TheDarkKiwi/RoboCup/robocup cad/Evil_weight.jpg

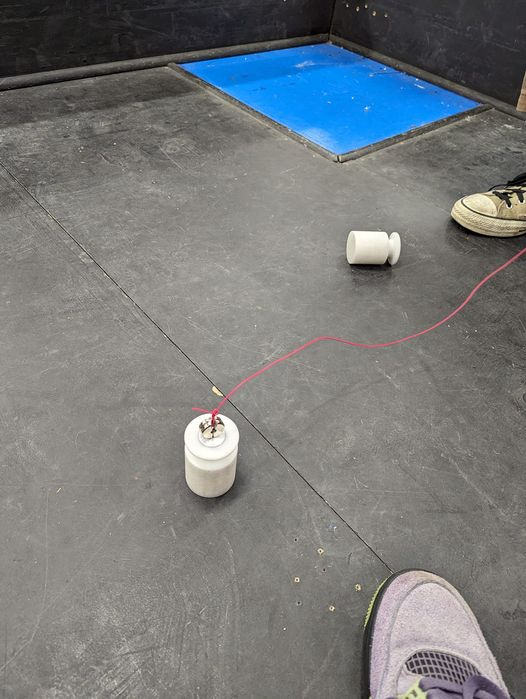
robocup cad/Evil_weight.jpg
