TheDarkKiwi/RoboCup/robocup cad/Side Cut Away.JPG

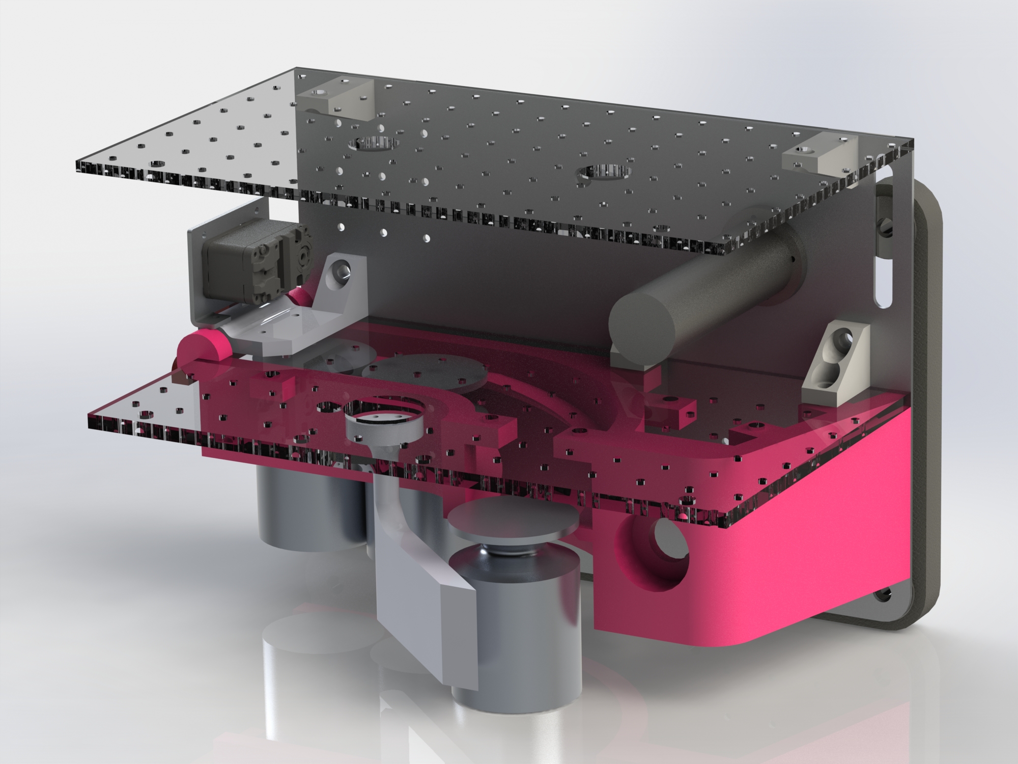
robocup cad/Side Cut Away.JPG
