TheDarkKiwi/RoboCup/robocup cad/eak38/CODE/bk_deltetemeifneeded/robocup-main/info.md

servo locations
544 = far back (push off)
1610 = flush / bypass
