TheDarkKiwi/RoboCup/robocup cad/2_half_hour render_lol.JPG

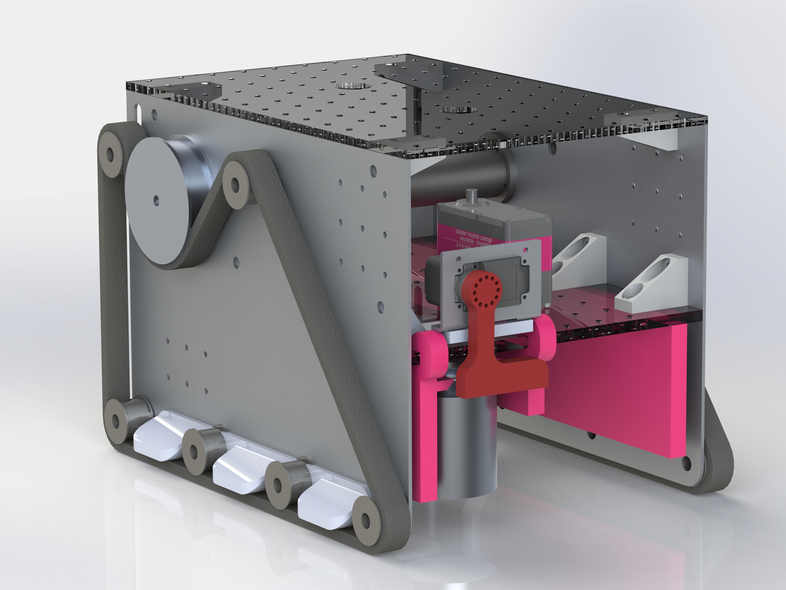
robocup cad/2_half_hour render_lol.JPG
