TheDarkKiwi/RoboCup/robocup cad/bad pic.png

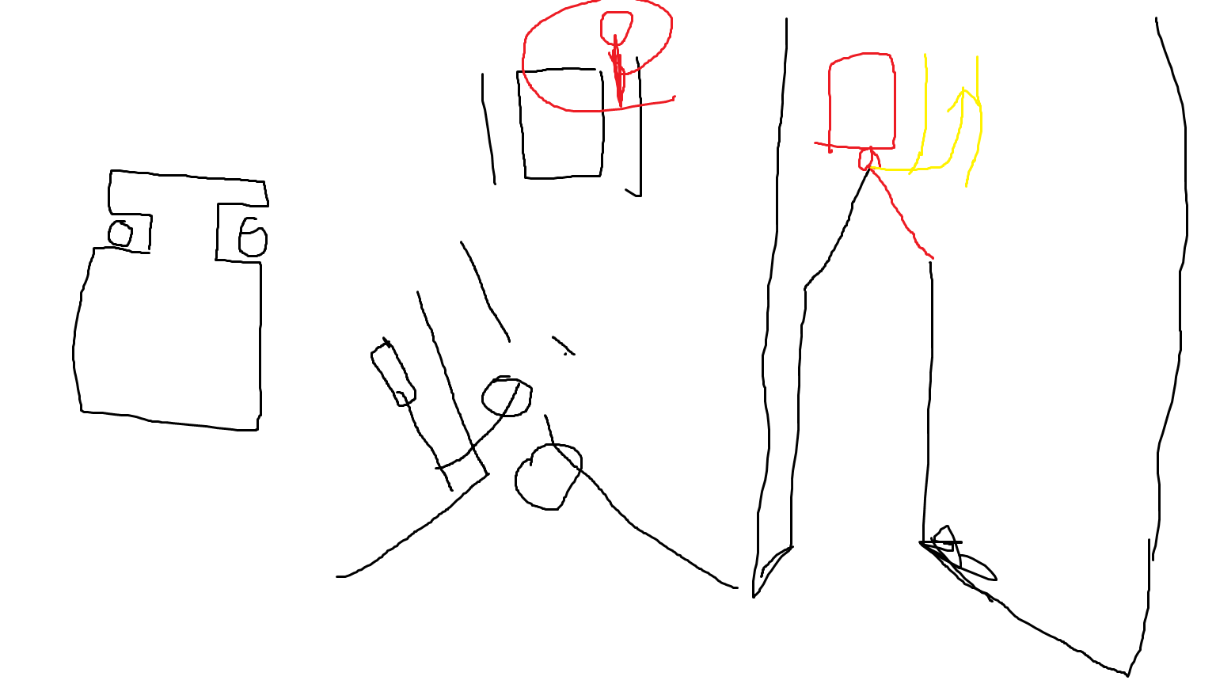
robocup cad/bad pic.png
