TheDarkKiwi/RoboCup/robocup cad/dee21/Custom Side Plate.PNG

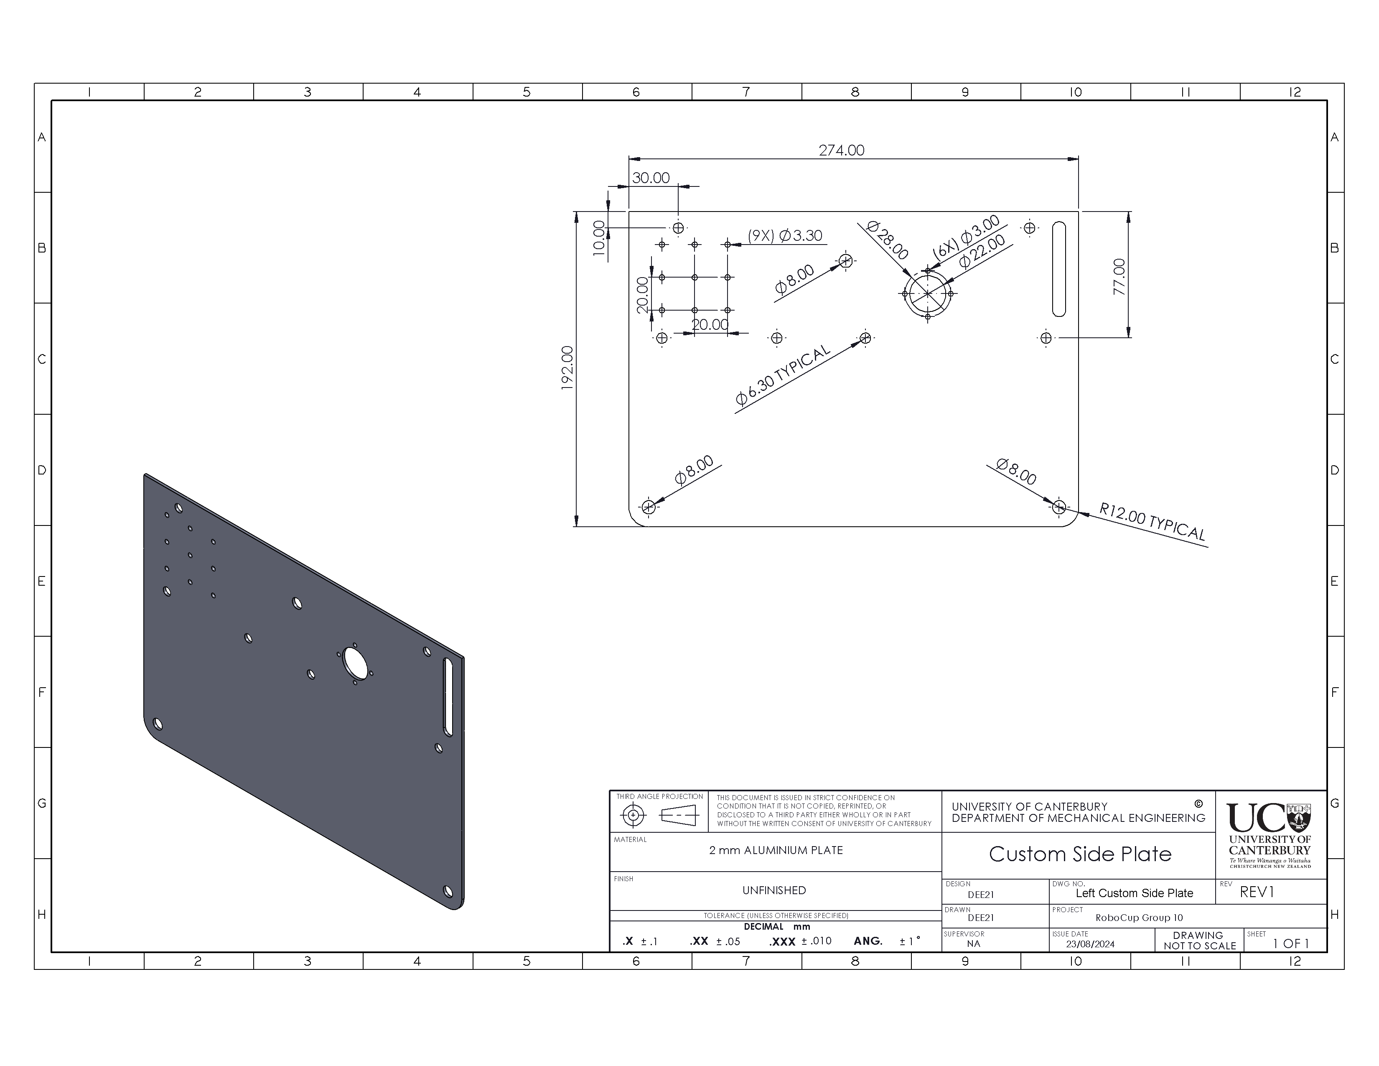
robocup cad/dee21/Custom Side Plate.PNG
