TheDarkKiwi/RoboCup/robocup cad/dee21/Internal passage way.PNG

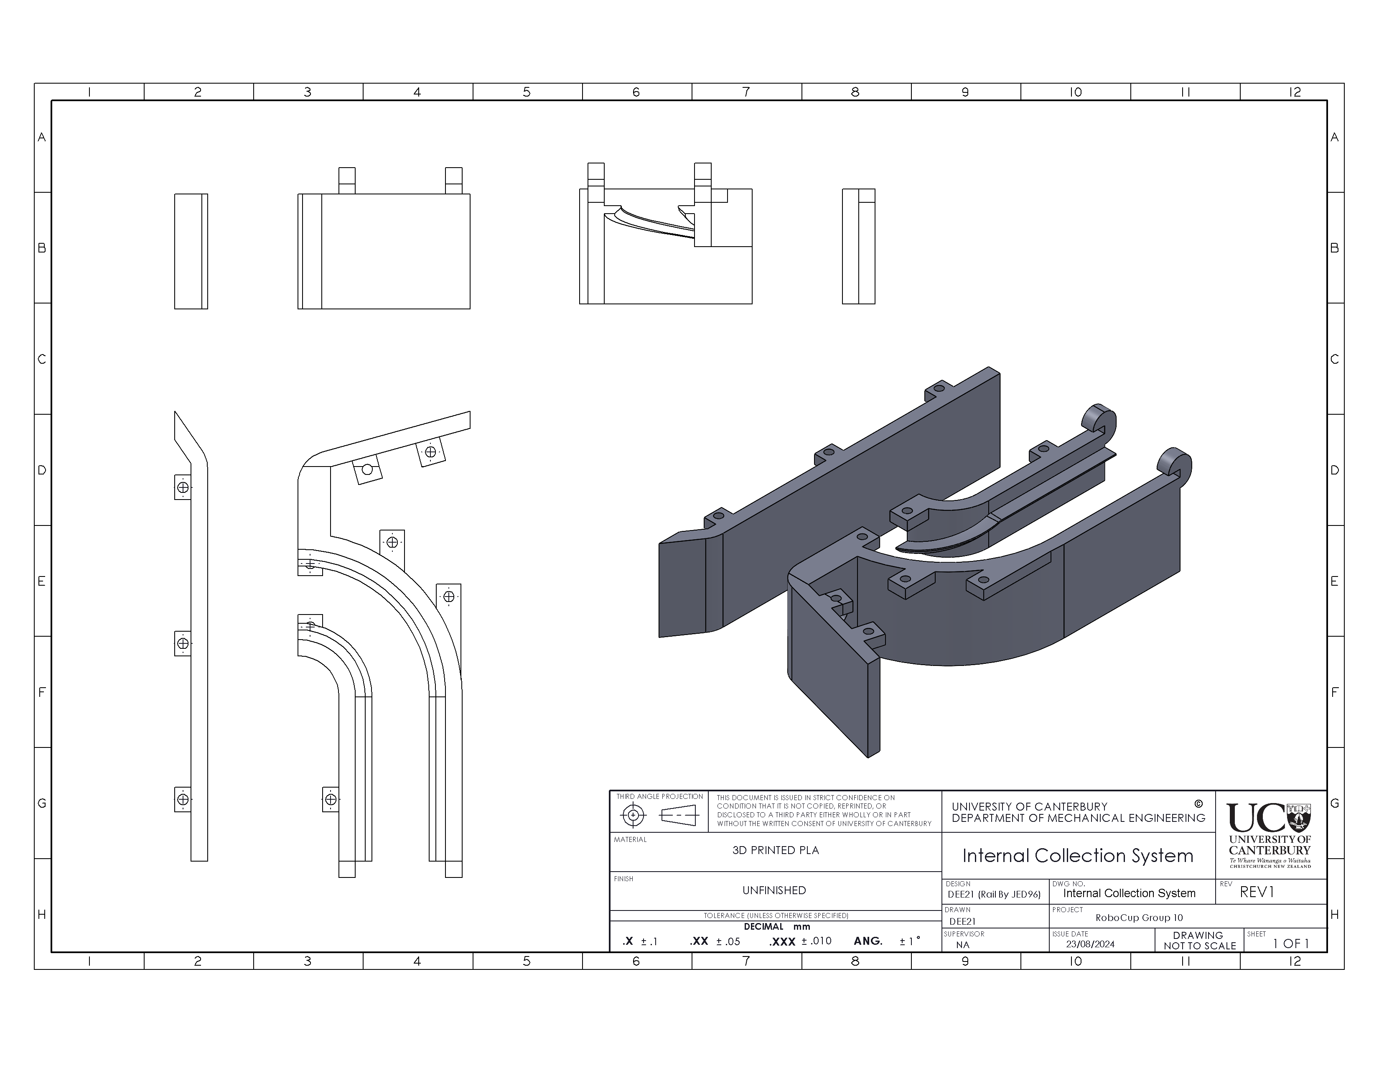
robocup cad/dee21/Internal passage way.PNG
