TheDarkKiwi/RoboCup/robocup cad/dee21/render 1.JPG

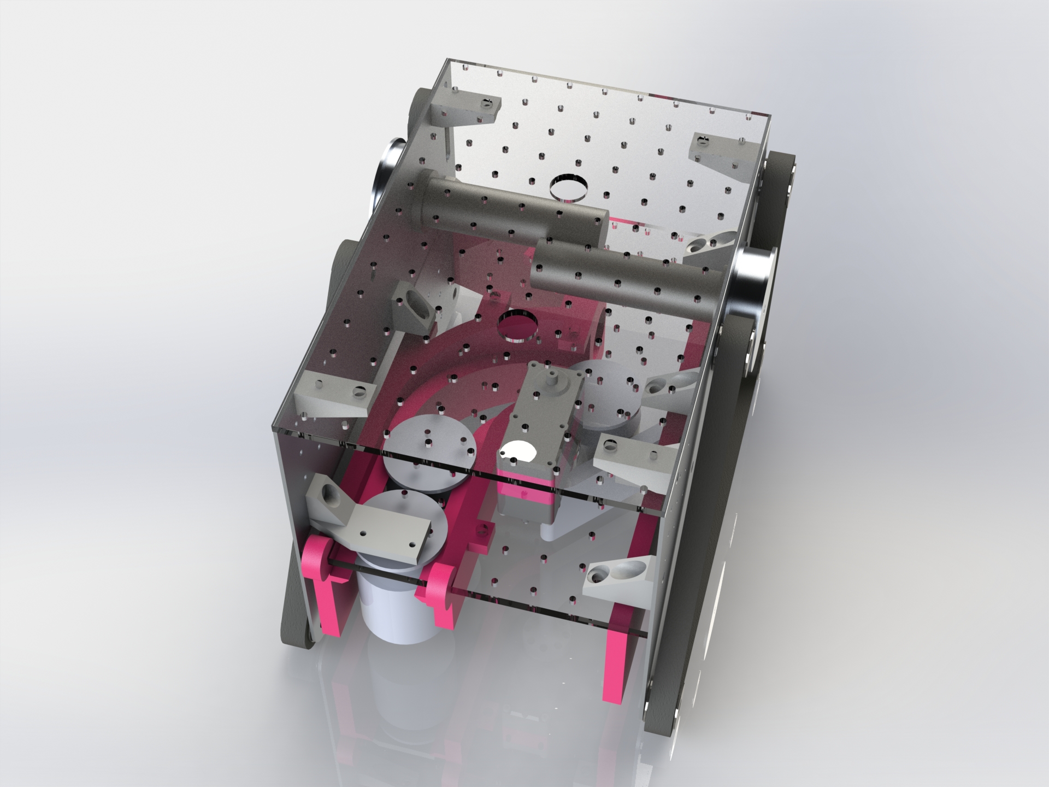
robocup cad/dee21/render 1.JPG
