TheDarkKiwi/RoboCup/robocup cad/DLparts/drs-0101-1.snapshot.2/Renderings/DRS-0101.jpg

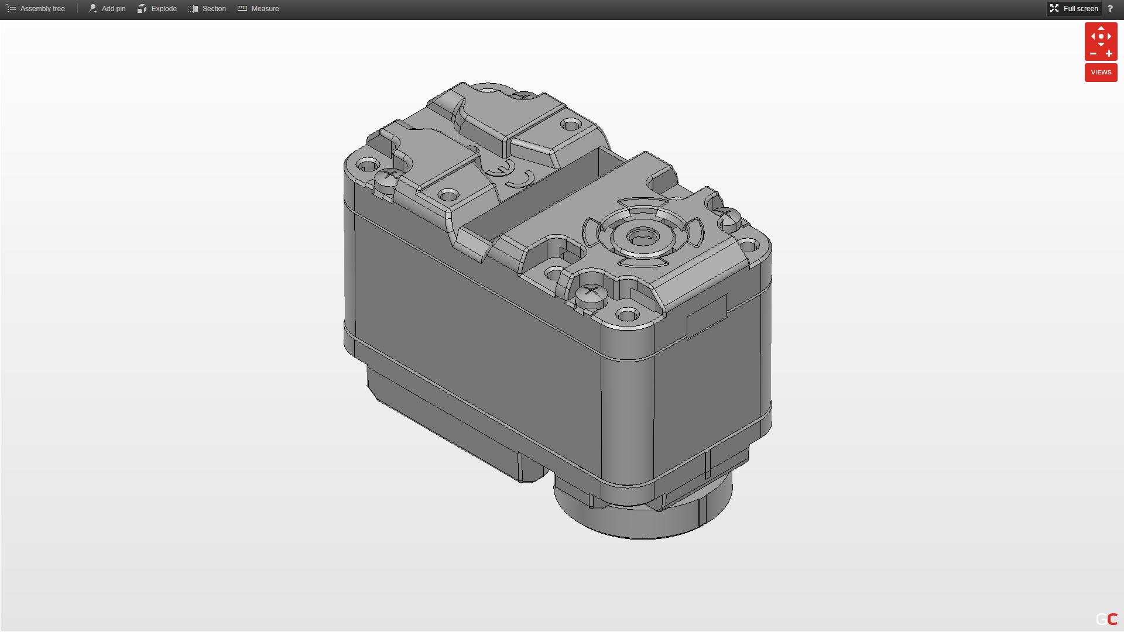
robocup cad/DLparts/drs-0101-1.snapshot.2/Renderings/DRS-0101.jpg
