TheDarkKiwi/RoboCup/robocup cad/DLparts/herculex-1.snapshot.1/Bracket.PNG

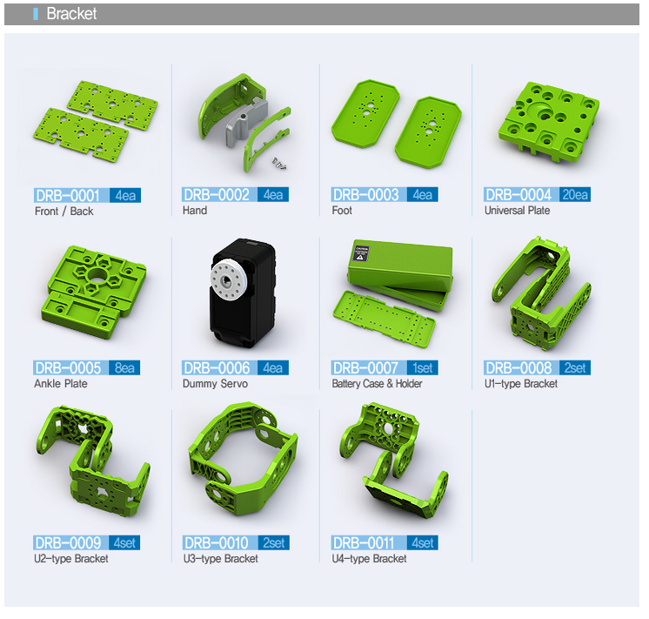
robocup cad/DLparts/herculex-1.snapshot.1/Bracket.PNG
