TheDarkKiwi/RoboCup/robocup cad/DLparts/herculex-1.snapshot.1/DRB-0001.PNG

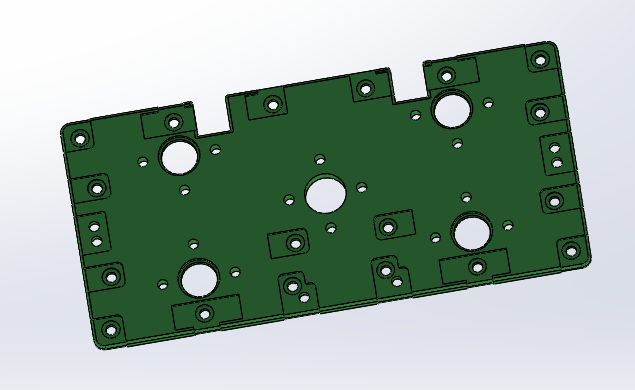
robocup cad/DLparts/herculex-1.snapshot.1/DRB-0001.PNG
