TheDarkKiwi/RoboCup/robocup cad/DLparts/herculex-1.snapshot.1/DSR-0001.JPG

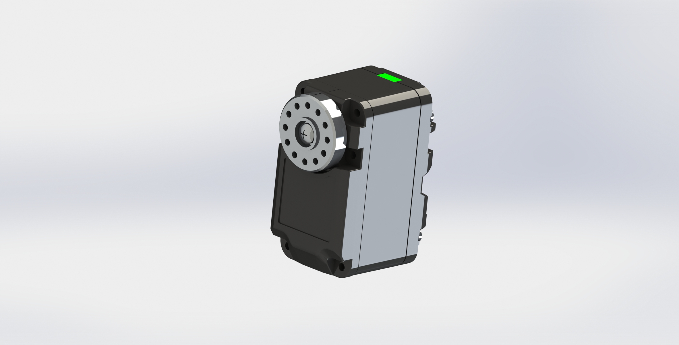
robocup cad/DLparts/herculex-1.snapshot.1/DSR-0001.JPG
