TheDarkKiwi/RoboCup/robocup cad/DLparts/herculex-1.snapshot.1/Joint.PNG

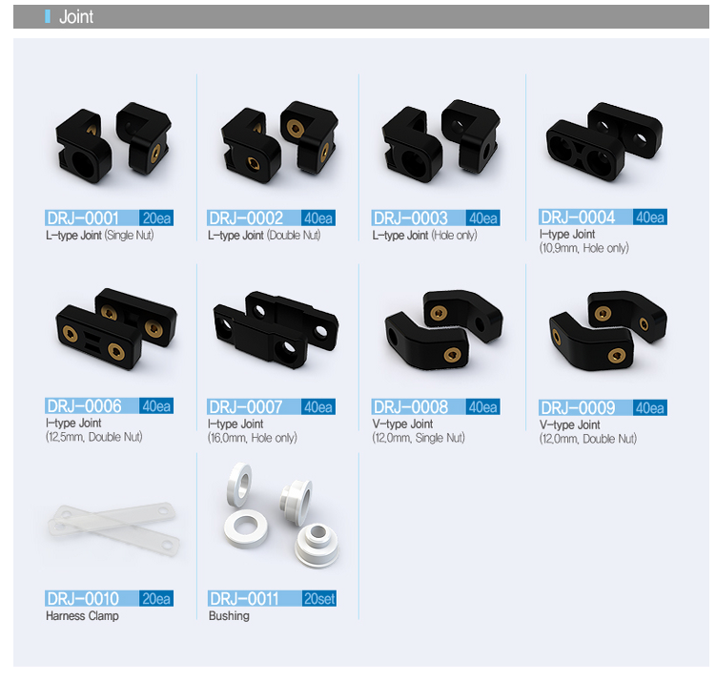
robocup cad/DLparts/herculex-1.snapshot.1/Joint.PNG
