TheDarkKiwi/RoboCup/robocup cad/Padawans_of_the_nerd_lord_accepting_their_fate.jpg

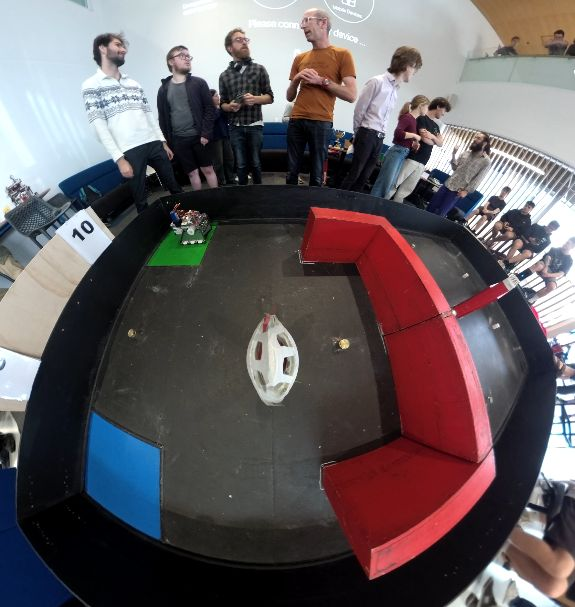
robocup cad/Padawans_of_the_nerd_lord_accepting_their_fate.jpg
