TheDarkKiwi/RoboCup/robocup cad/Screenshot 2024-08-05 134314.png

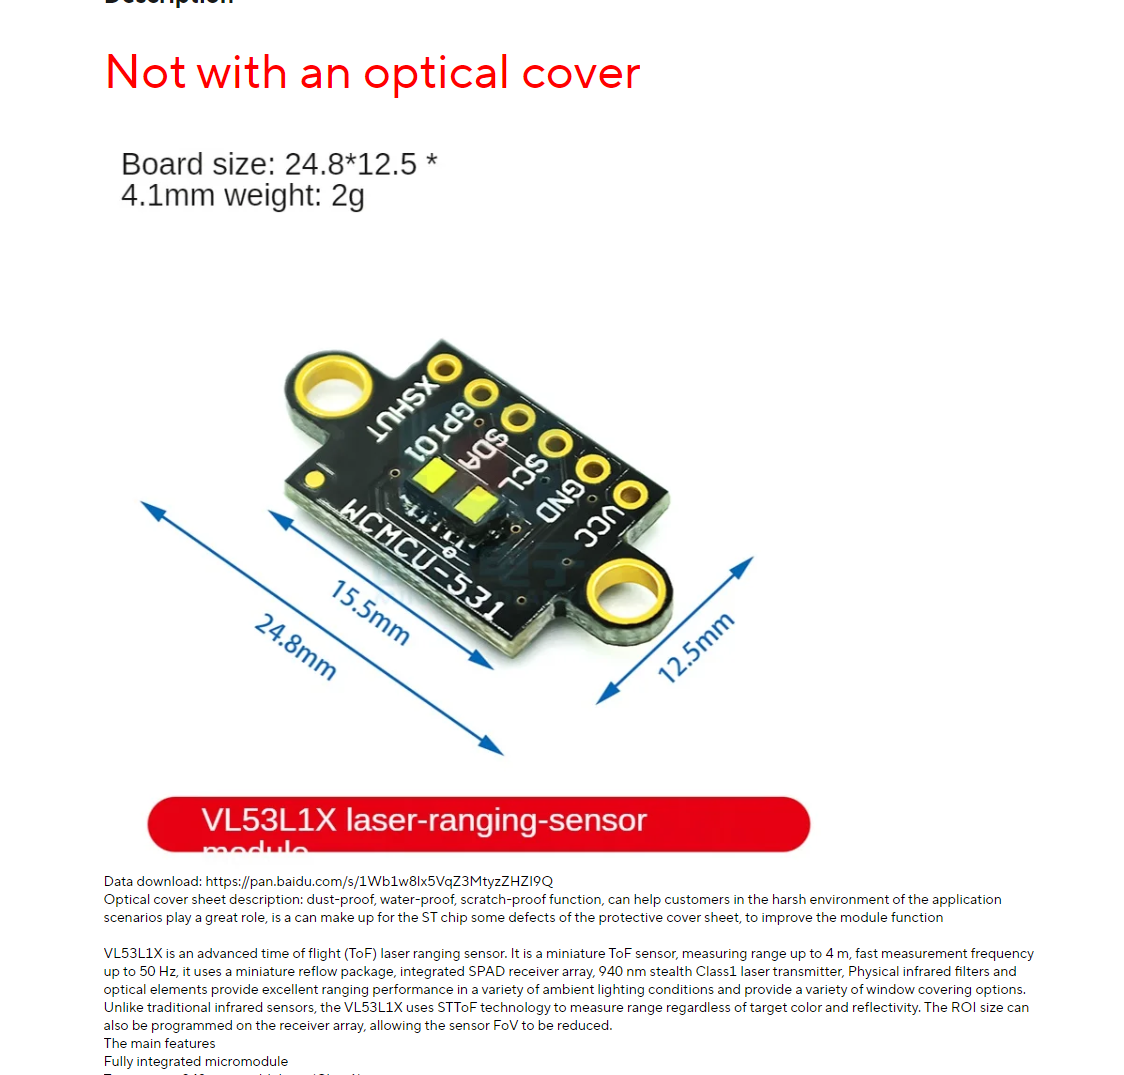
robocup cad/Screenshot 2024-08-05 134314.png
