TheDarkKiwi/RoboCup/robocup cad/DLparts/vl5310xother/Sensor assem.SLDASM

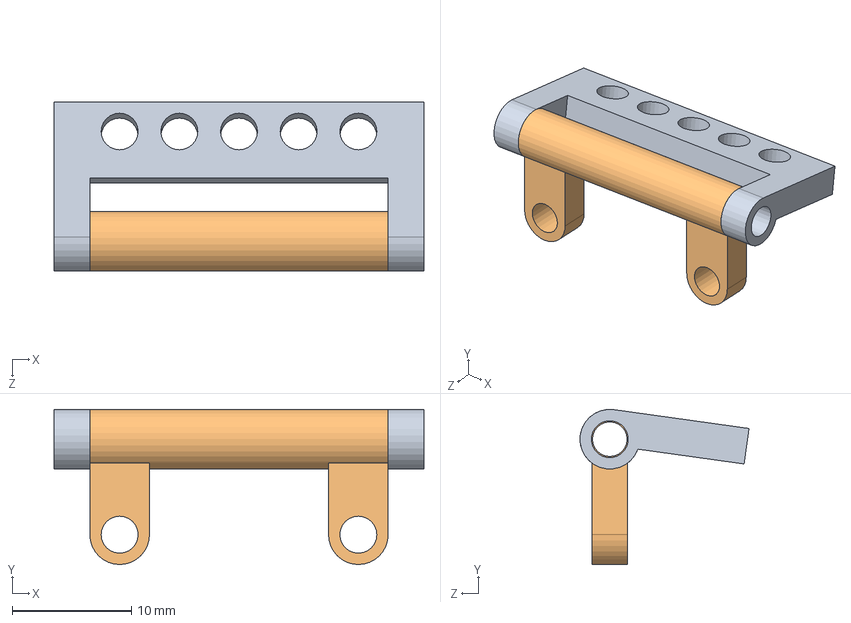
[picture p26: CAD file, 2024-12-19]
robocup cad/DLparts/vl5310xother/Sensor assem.SLDASM
31.0 x 13.0 x 14.2 mm
Sensor Mount
Sensor Mount - 2
