TheDarkKiwi/RoboCup/robocup cad/dee21/-electromagnet-customsize.SLDPRT

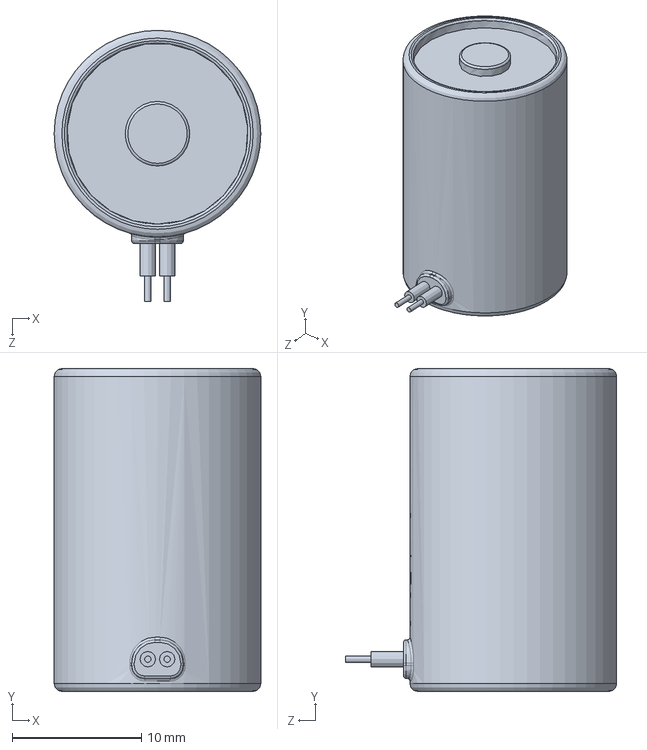
[picture p27: CAD file, 2024-12-19]
robocup cad/dee21/-electromagnet-customsize.SLDPRT
16.0 x 25.0 x 21.0 mm
