TheDarkKiwi/RoboCup/robocup cad/DLparts/drs-0101-1.snapshot.2/[HerkuleX] DRS-010X.stp

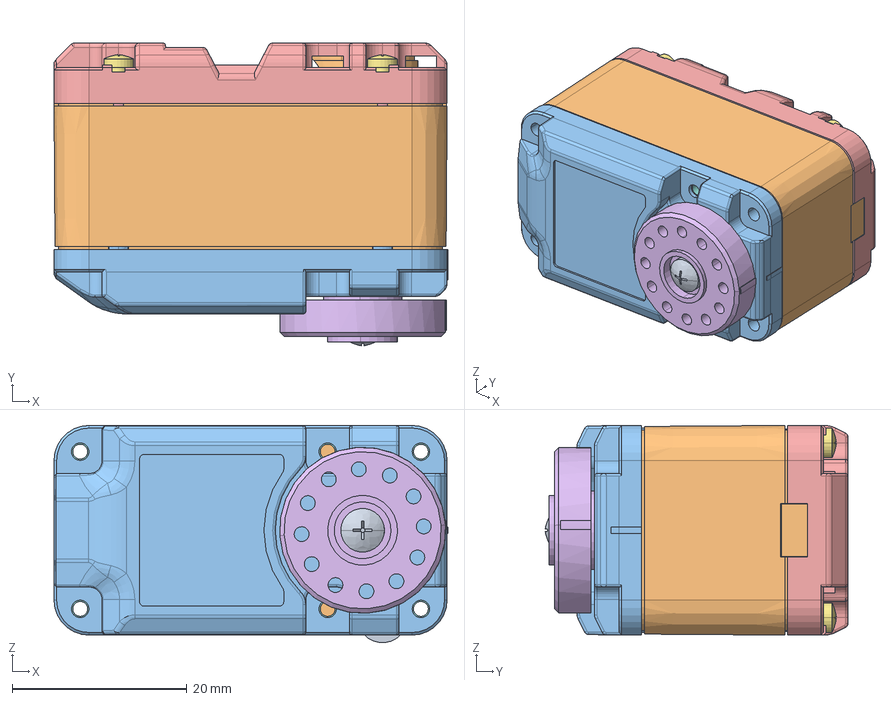
[picture p28: CAD file, 2024-12-19]
robocup cad/DLparts/drs-0101-1.snapshot.2/[HerkuleX] DRS-010X.stp
45.1 x 34.7 x 24.9 mm
CASE_228
TOP_191
MR106_9
BOTTOM_CASE_290
HORN_44
KSB1023A_T2X25NI_147 x 4
INNER_NUT_14 x 6
KSB1023A_M2_5X8Z_147
LED_LENSE_101
