TheDarkKiwi/RoboCup/robocup cad/DLparts/herculex-1.snapshot.1/bracket/DRB-0007.step

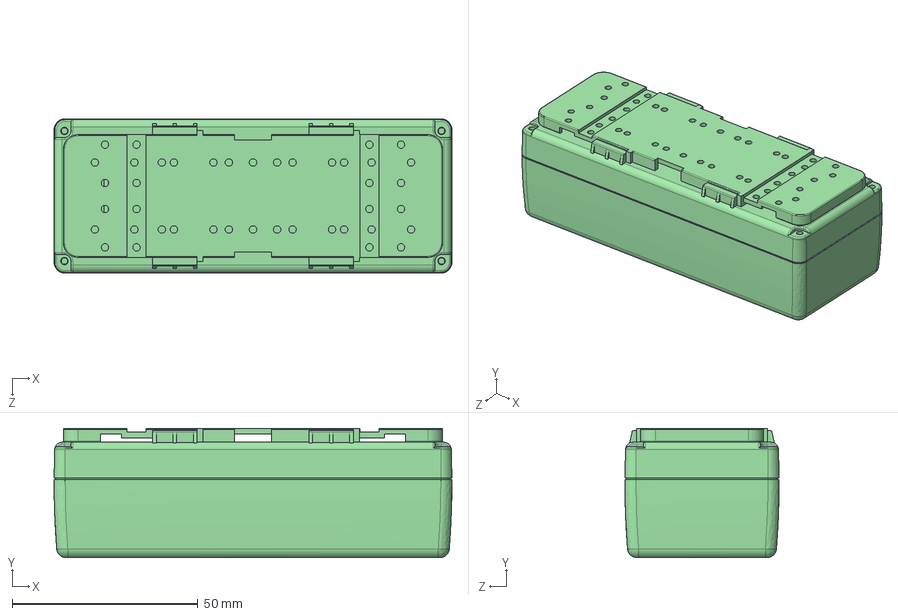
[picture p29: CAD file, 2024-12-19]
robocup cad/DLparts/herculex-1.snapshot.1/bracket/DRB-0007.step
107.0 x 34.7 x 41.5 mm
