TheDarkKiwi/RoboCup/robocup cad/DLparts/herculex-1.snapshot.1/Joint/DRJ-0006.step

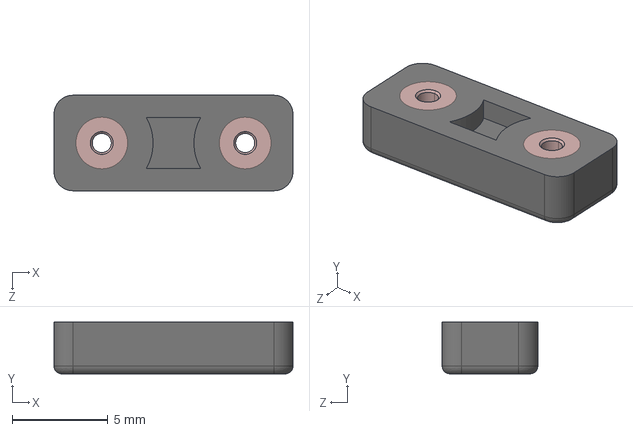
[picture p30: CAD file, 2024-12-19]
robocup cad/DLparts/herculex-1.snapshot.1/Joint/DRJ-0006.step
12.5 x 2.70 x 5.00 mm
