TheDarkKiwi/RoboCup/robocup cad/DLparts/herculex-1.snapshot.1/motor/DSR-060X.step

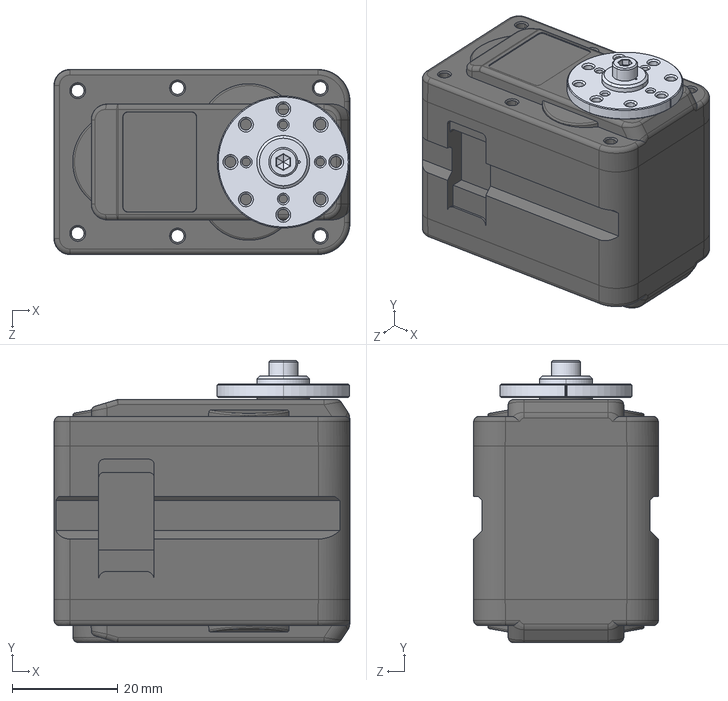
[picture p31: CAD file, 2024-12-19]
robocup cad/DLparts/herculex-1.snapshot.1/motor/DSR-060X.step
56.0 x 53.4 x 35.0 mm
