TheDarkKiwi/RoboCup/robocup cad/DLparts/vl5310xother/Sensor Mount - 2.SLDPRT

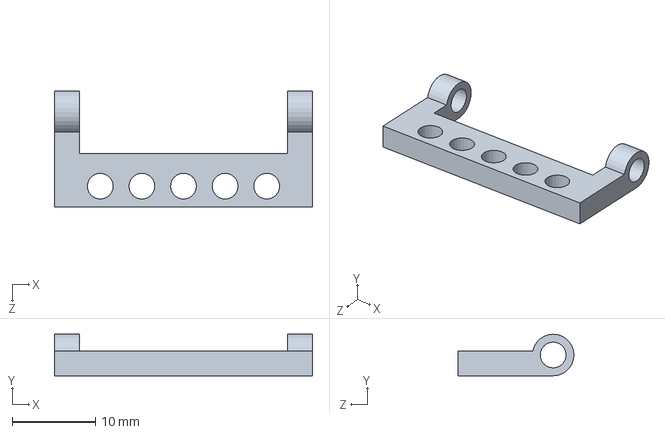
[picture p32: CAD file, 2024-12-19]
robocup cad/DLparts/vl5310xother/Sensor Mount - 2.SLDPRT
31.0 x 5.00 x 13.9 mm
