TheDarkKiwi/RoboCup/robocup cad/DLparts/vl53l0xslightlyworser/vl53l0x.STEP

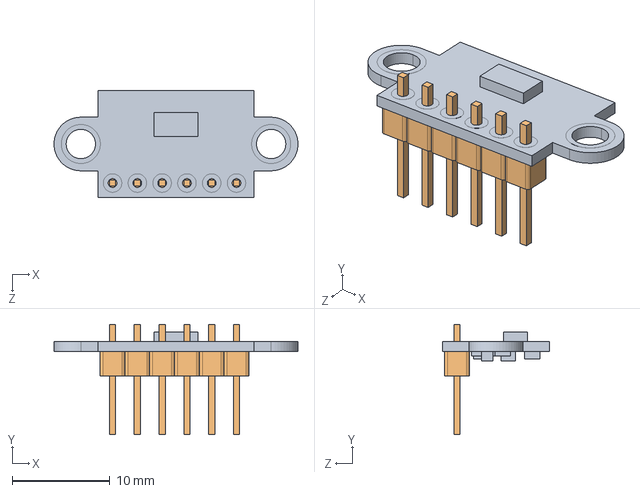
[picture p33: CAD file, 2024-12-19]
robocup cad/DLparts/vl53l0xslightlyworser/vl53l0x.STEP
25.0 x 11.3 x 11.0 mm
vl53l0x_PCB
pin_header x 6
