TheDarkKiwi/RoboCup/robocup cad/eak38/RGBsensor.SLDPRT

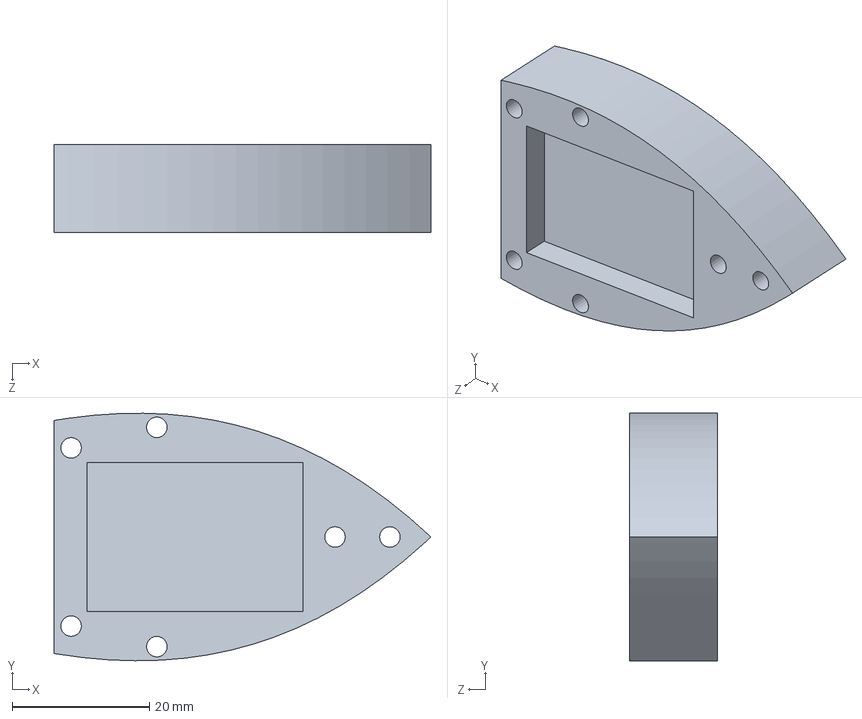
[picture p34: CAD file, 2024-12-19]
robocup cad/eak38/RGBsensor.SLDPRT
55.0 x 36.1 x 12.9 mm
