TheDarkKiwi/RoboCup/robocup cad/jed96/Battery holder.SLDPRT

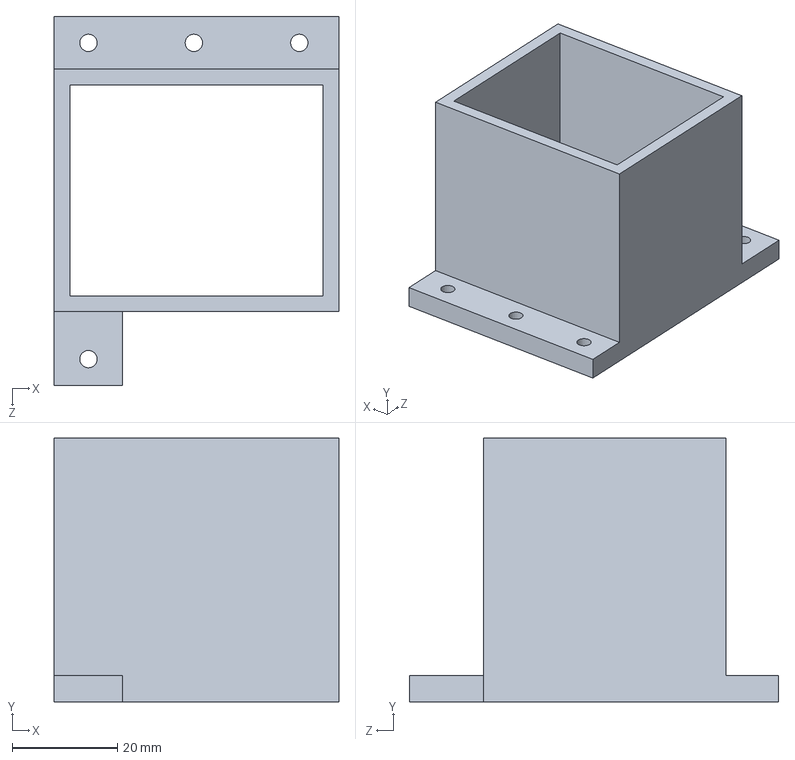
[picture p35: CAD file, 2024-12-19]
robocup cad/jed96/Battery holder.SLDPRT
54.0 x 50.0 x 70.0 mm
