TheDarkKiwi/RoboCup/robocup cad/joint/servo mag arm 2.SLDPRT

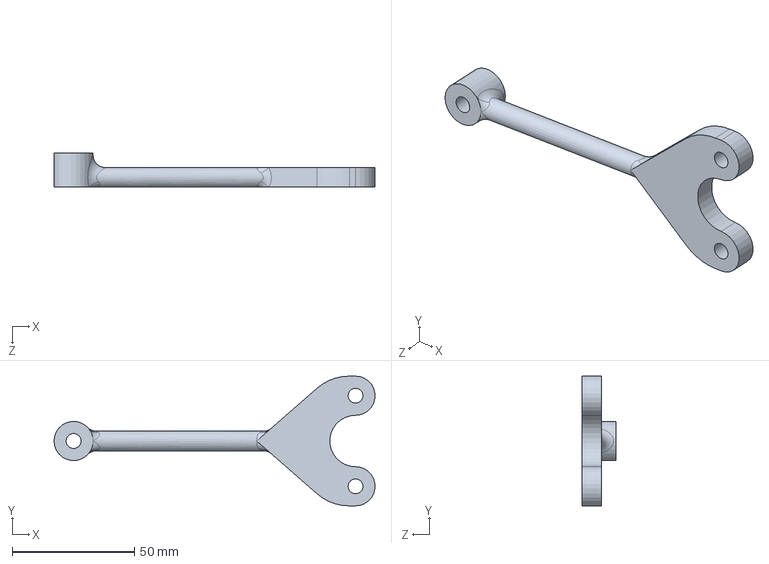
[picture p36: CAD file, 2024-12-19]
robocup cad/joint/servo mag arm 2.SLDPRT
131.1 x 53.0 x 14.0 mm
