TheDarkKiwi/RoboCup/robocup cad/WheelSliderEDIT.SLDPRT

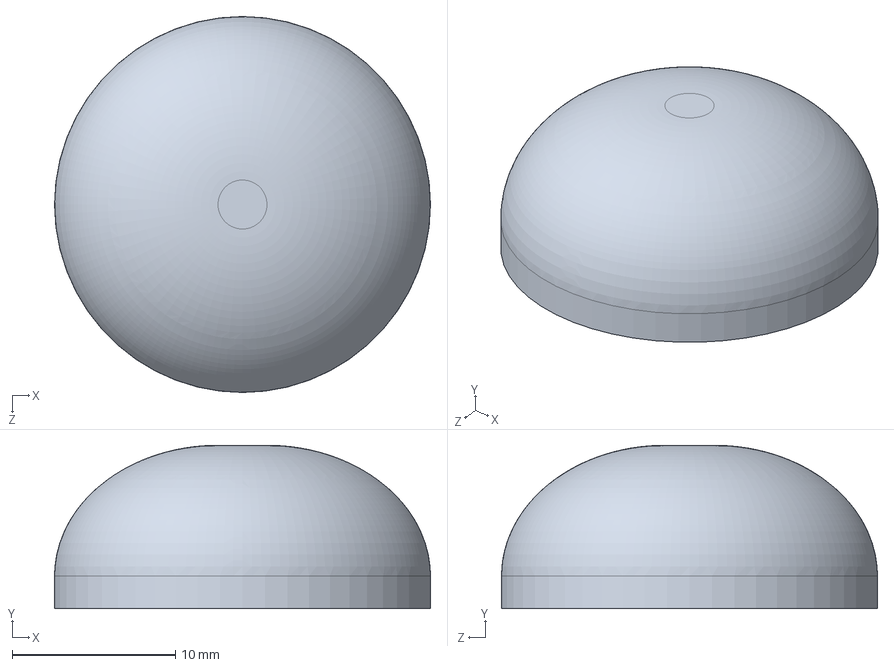
[picture p37: CAD file, 2024-12-19]
robocup cad/WheelSliderEDIT.SLDPRT
23.0 x 10.0 x 23.0 mm
