TheDarkKiwi/RoboCup/robocup cad/bearing sliders.STL

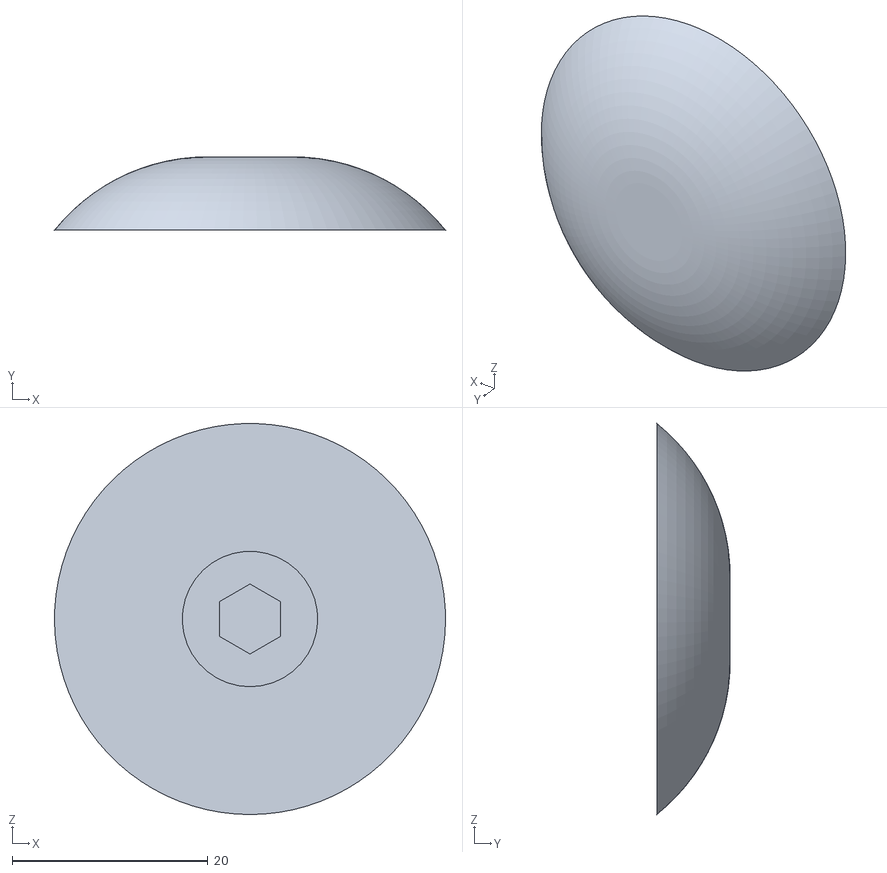
[picture p38: CAD file, 2024-12-19]
robocup cad/bearing sliders.STL
40.0 x 7.50 x 40.0
