TheDarkKiwi/RoboCup/robocup cad/dee21/side2collection3.SLDPRT

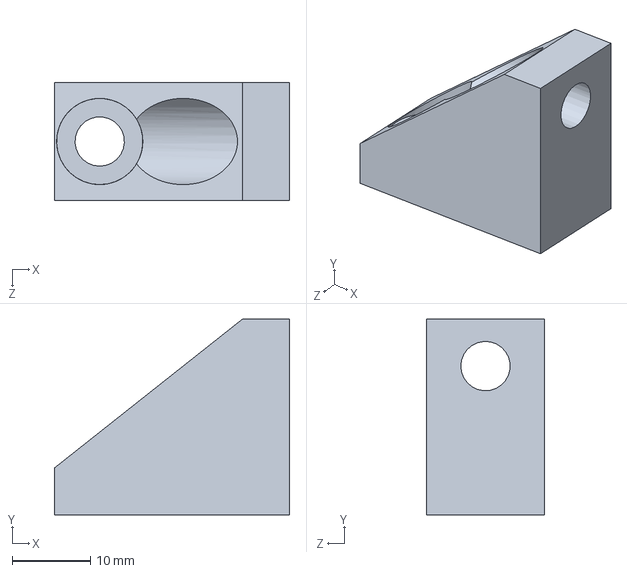
[picture p39: CAD file, 2024-12-19]
robocup cad/dee21/side2collection3.SLDPRT
30.0 x 25.0 x 15.0 mm
