TheDarkKiwi/RoboCup/robocup cad/DLparts/herculex-1.snapshot.1/bracket/DRB-0008.SLDPRT

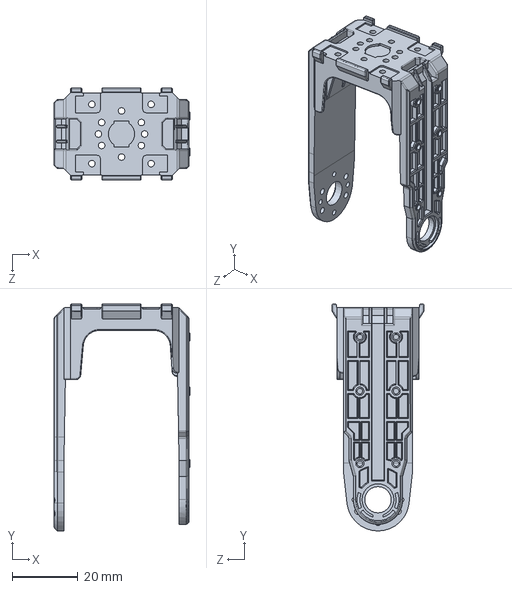
[picture p40: CAD file, 2024-12-19]
robocup cad/DLparts/herculex-1.snapshot.1/bracket/DRB-0008.SLDPRT
41.3 x 69.0 x 28.0 mm
