TheDarkKiwi/RoboCup/robocup cad/DLparts/herculex-1.snapshot.1/Joint/DRJ-0003.step

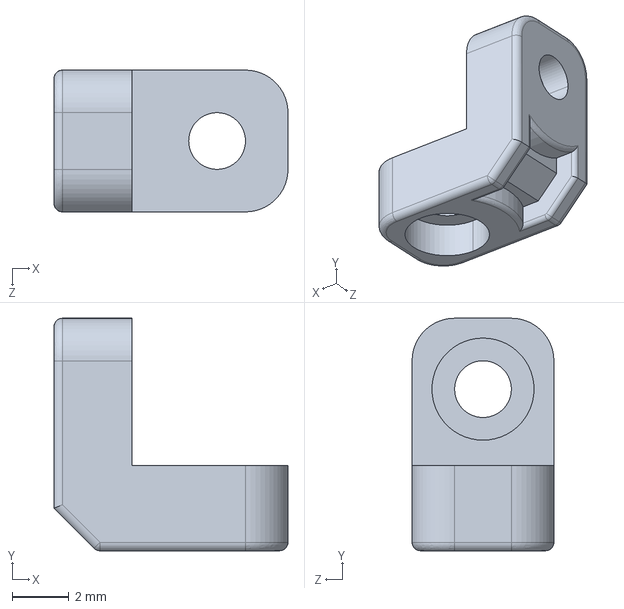
[picture p41: CAD file, 2024-12-19]
robocup cad/DLparts/herculex-1.snapshot.1/Joint/DRJ-0003.step
8.25 x 8.20 x 5.00 mm
