TheDarkKiwi/RoboCup/robocup cad/DLparts/herculex-1.snapshot.1/motor/DSR-040X.step

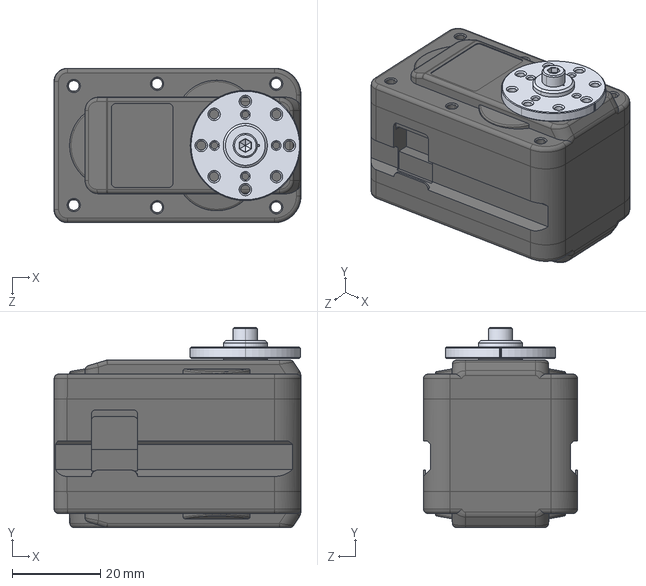
[picture p42: CAD file, 2024-12-19]
robocup cad/DLparts/herculex-1.snapshot.1/motor/DSR-040X.step
56.0 x 45.4 x 35.0 mm
