TheDarkKiwi/RoboCup/robocup cad/DLparts/vl5310xother/Sensor Mount.SLDPRT

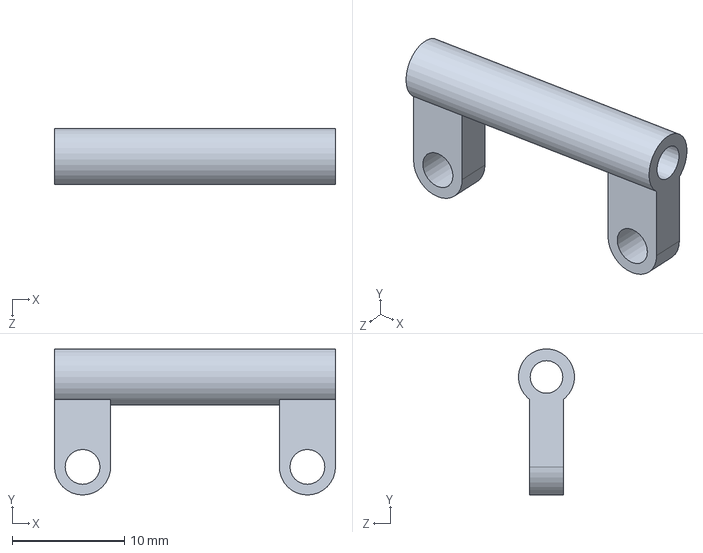
[picture p43: CAD file, 2024-12-19]
robocup cad/DLparts/vl5310xother/Sensor Mount.SLDPRT
25.0 x 13.0 x 5.00 mm
