TheDarkKiwi/RoboCup/robocup cad/DLparts/vl53l0xslightlyworser/vl53l0x no headers.STEP

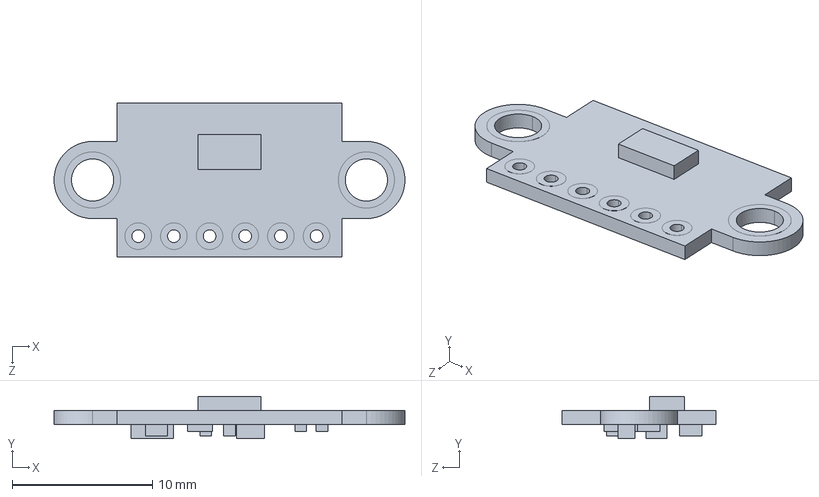
[picture p44: CAD file, 2024-12-19]
robocup cad/DLparts/vl53l0xslightlyworser/vl53l0x no headers.STEP
25.0 x 3.00 x 11.0 mm
