TheDarkKiwi/RoboCup/robocup cad/eak38/Door3.SLDPRT

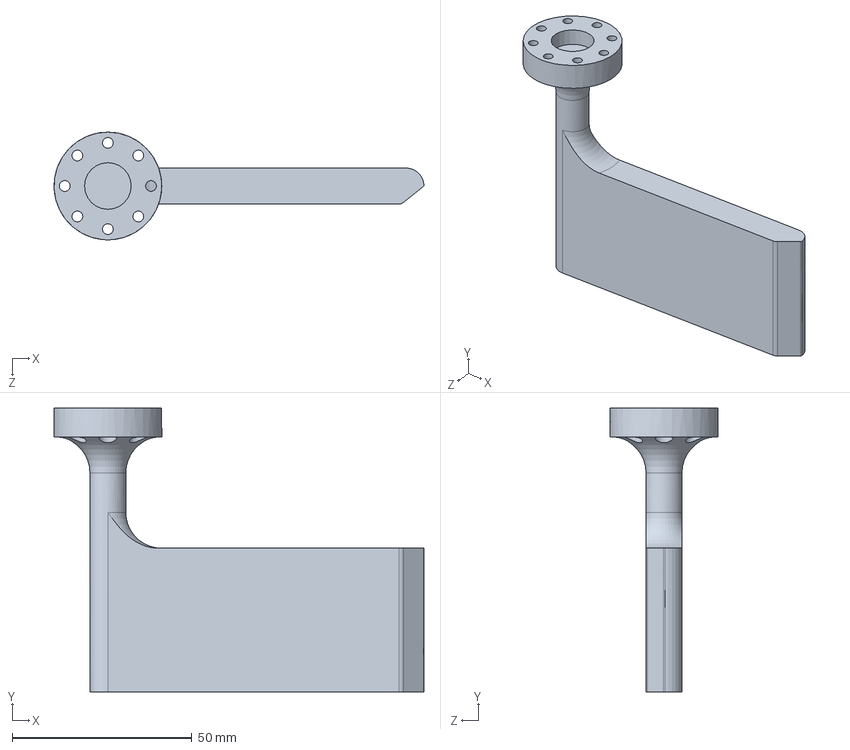
[picture p45: CAD file, 2024-12-19]
robocup cad/eak38/Door3.SLDPRT
103.0 x 79.0 x 30.0 mm
