TheDarkKiwi/RoboCup/robocup cad/jed96/entry.SLDPRT

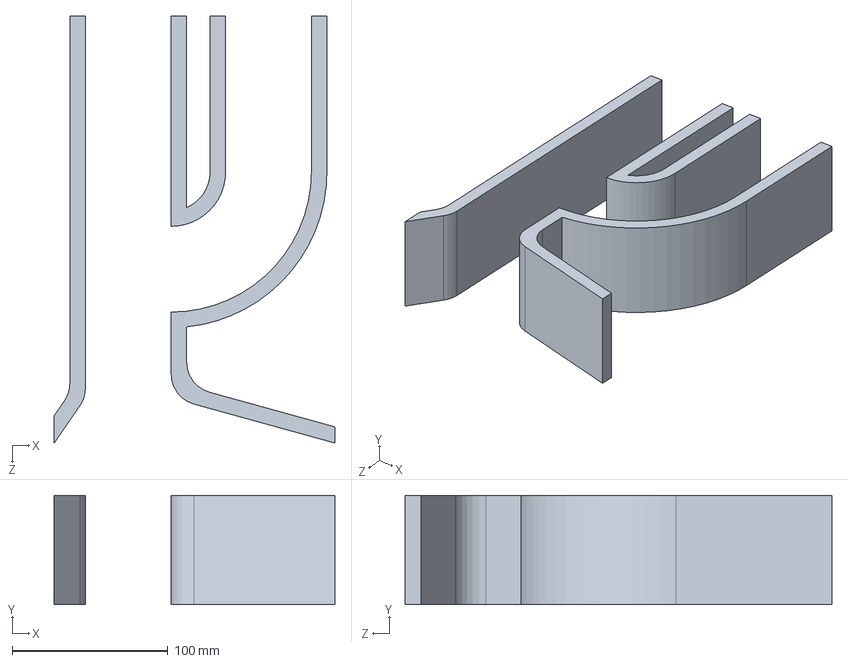
[picture p46: CAD file, 2024-12-19]
robocup cad/jed96/entry.SLDPRT
180.0 x 70.0 x 274.0 mm
