TheDarkKiwi/RoboCup/robocup cad/joint/electromagnet.SLDPRT

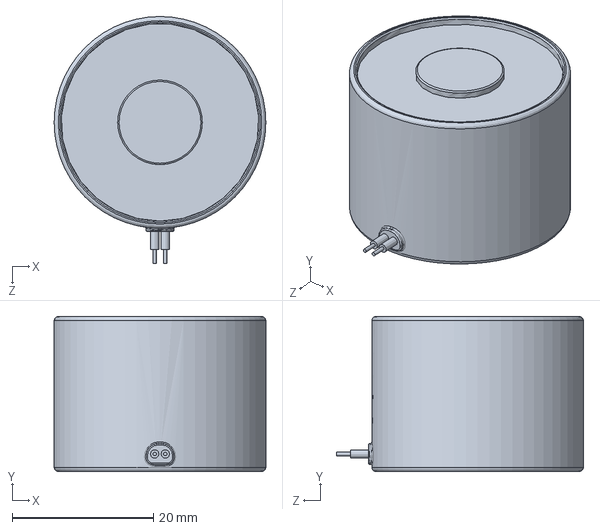
[picture p47: CAD file, 2024-12-19]
robocup cad/joint/electromagnet.SLDPRT
30.0 x 22.0 x 35.0 mm
