TheDarkKiwi/RoboCup/robocup cad/DLparts/herculex-1.snapshot.1/bracket/DRB-0005.step

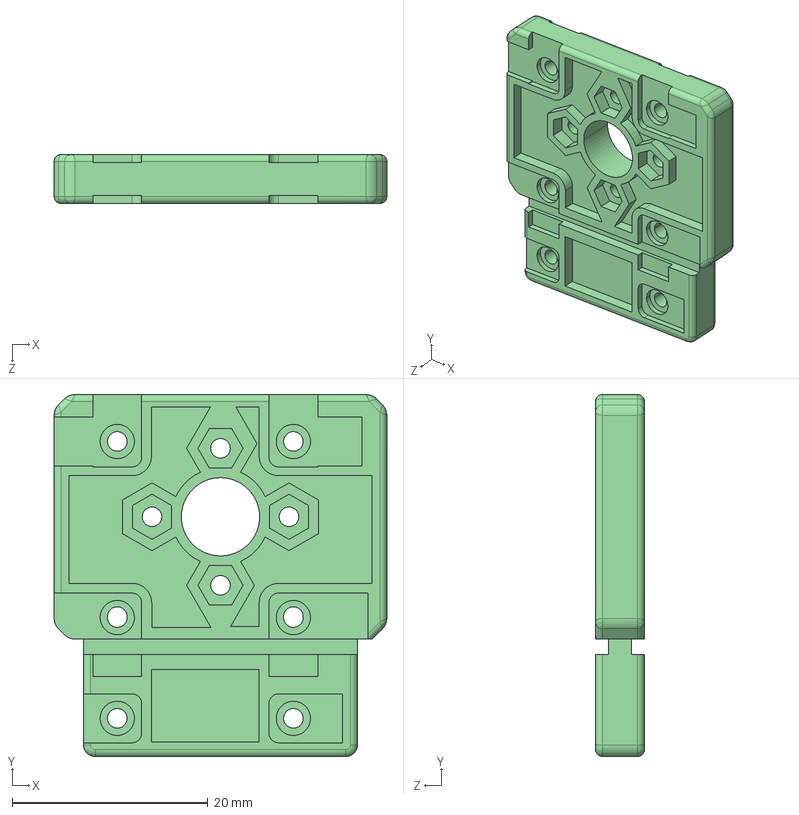
[picture p48: CAD file, 2024-12-19]
robocup cad/DLparts/herculex-1.snapshot.1/bracket/DRB-0005.step
34.0 x 37.0 x 5.00 mm
