TheDarkKiwi/RoboCup/robocup cad/DLparts/herculex-1.snapshot.1/Joint/DRJ-0004.step

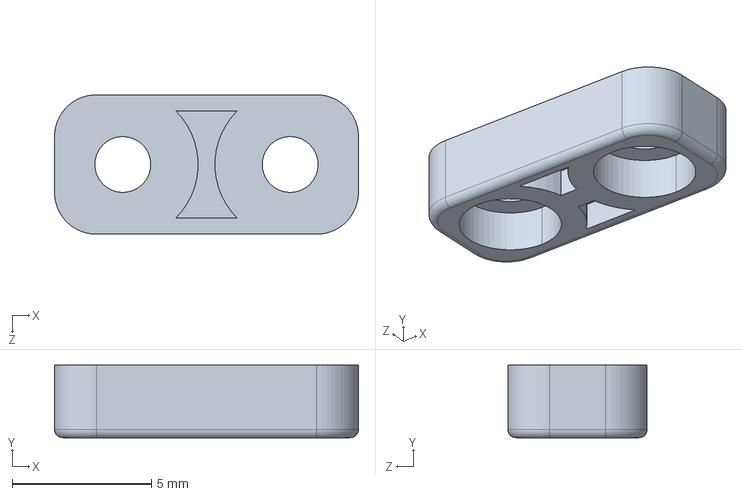
[picture p49: CAD file, 2024-12-19]
robocup cad/DLparts/herculex-1.snapshot.1/Joint/DRJ-0004.step
10.9 x 2.60 x 5.00 mm
