TheDarkKiwi/RoboCup/robocup cad/DLparts/herculex-1.snapshot.1/motor/DSR-0101.SLDPRT

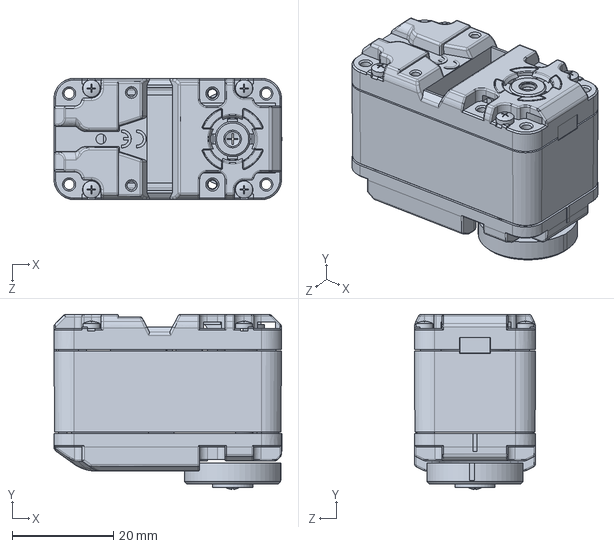
[picture p50: CAD file, 2024-12-19]
robocup cad/DLparts/herculex-1.snapshot.1/motor/DSR-0101.SLDPRT
45.1 x 34.7 x 24.0 mm
