TheDarkKiwi/RoboCup/robocup cad/eak38/smartservobracket-MECH2305.SLDPRT

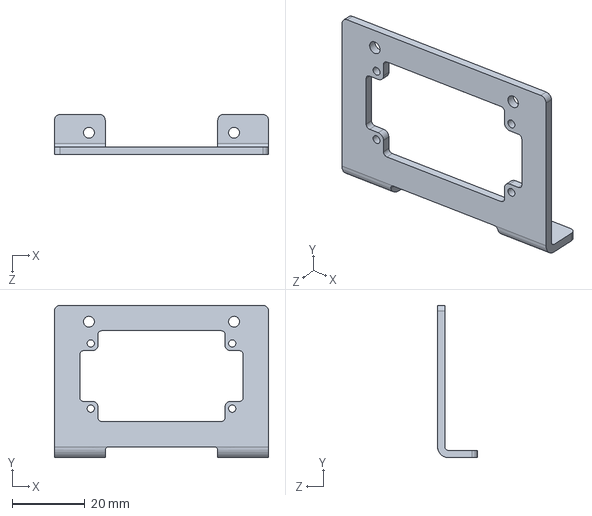
[picture p51: CAD file, 2024-12-19]
robocup cad/eak38/smartservobracket-MECH2305.SLDPRT
59.0 x 42.0 x 11.0 mm
