TheDarkKiwi/RoboCup/robocup cad/jed96/herkulex_motor.SLDPRT

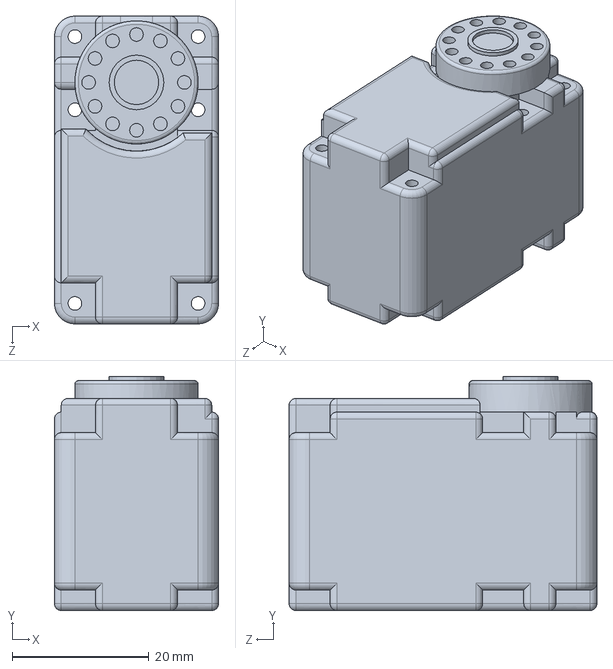
[picture p52: CAD file, 2024-12-19]
robocup cad/jed96/herkulex_motor.SLDPRT
24.0 x 34.2 x 45.0 mm
