TheDarkKiwi/RoboCup/robocup cad/joint/60kg servo mount.SLDPRT

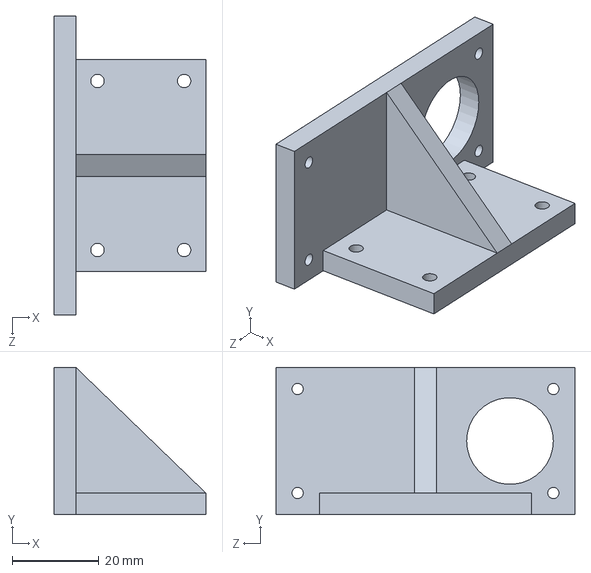
[picture p53: CAD file, 2024-12-19]
robocup cad/joint/60kg servo mount.SLDPRT
35.0 x 34.0 x 69.0 mm
