TheDarkKiwi/RoboCup/robocup cad/Skids.SLDPRT

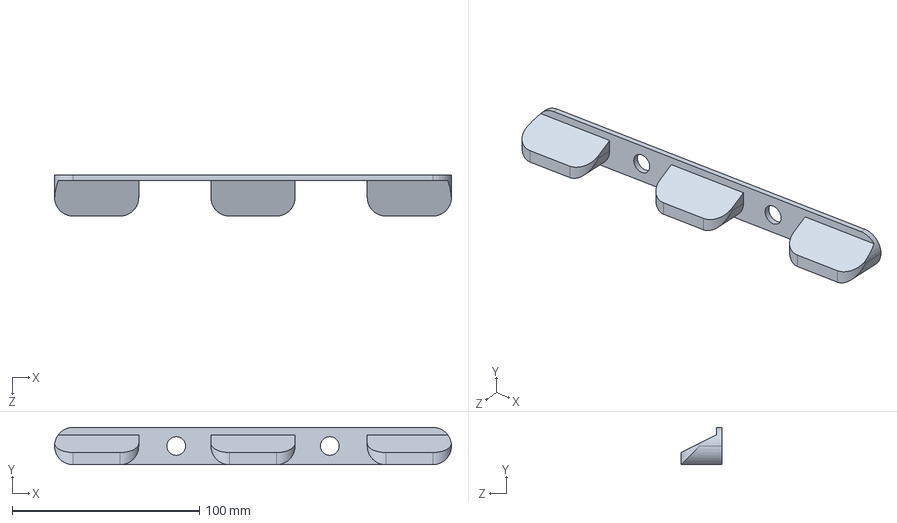
[picture p54: CAD file, 2024-12-19]
robocup cad/Skids.SLDPRT
212.0 x 20.0 x 22.0 mm
