TheDarkKiwi/RoboCup/robocup cad/dee21/Internal passage way 3.STL

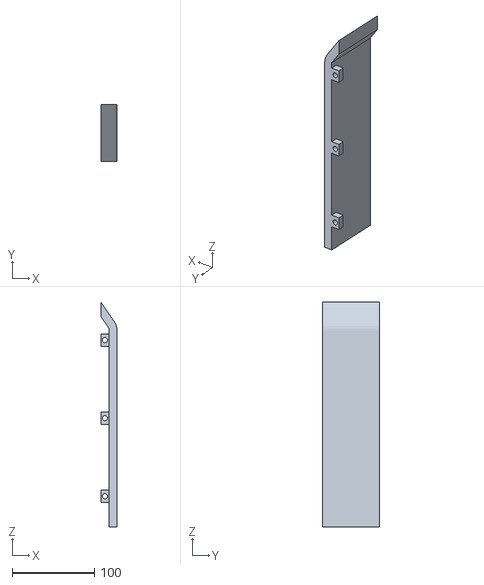
[picture p55: CAD file, 2024-12-19]
robocup cad/dee21/Internal passage way 3.STL
20.0 x 70.0 x 274.0
