TheDarkKiwi/RoboCup/robocup cad/DLparts/herculex-1.snapshot.1/bracket/DRB-0003.step

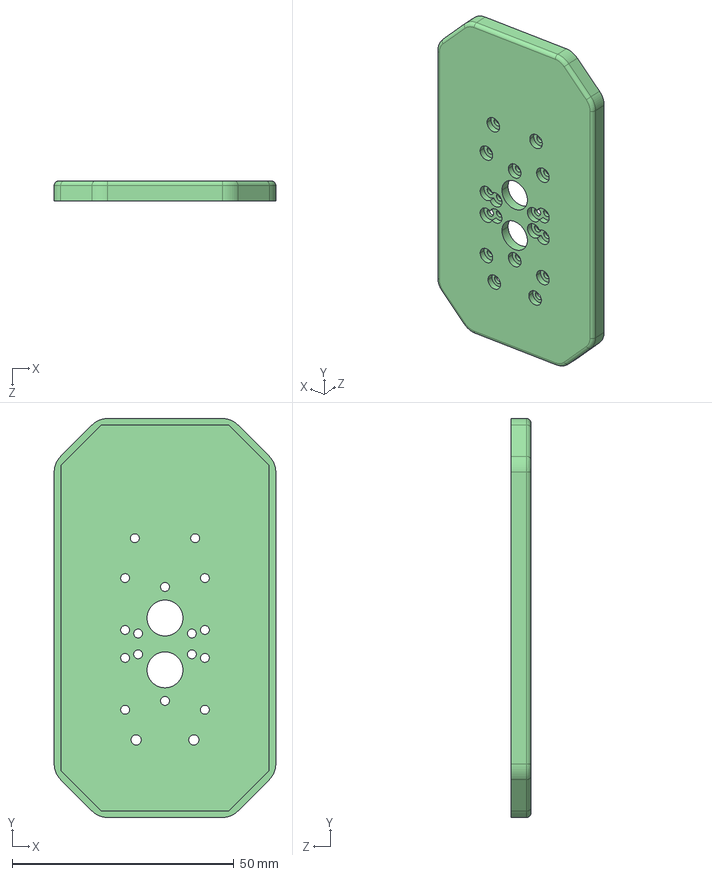
[picture p56: CAD file, 2024-12-19]
robocup cad/DLparts/herculex-1.snapshot.1/bracket/DRB-0003.step
50.0 x 90.0 x 4.50 mm
