TheDarkKiwi/RoboCup/robocup cad/DLparts/vl5310xother/VL53l1X.STEP

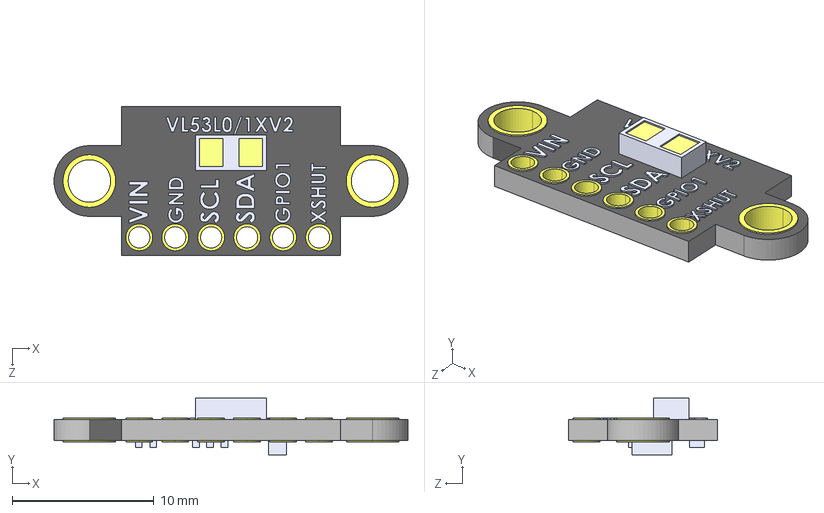
[picture p58: CAD file, 2024-12-19]
robocup cad/DLparts/vl5310xother/VL53l1X.STEP
25.0 x 4.00 x 10.5 mm
