TheDarkKiwi/RoboCup/robocup cad/DLparts/vl53l0xslightlyworser/pin_header.SLDPRT

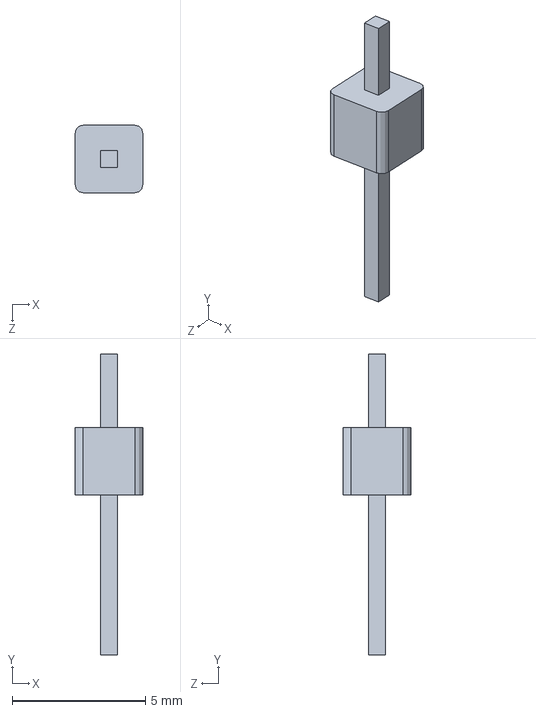
[picture p59: CAD file, 2024-12-19]
robocup cad/DLparts/vl53l0xslightlyworser/pin_header.SLDPRT
2.54 x 11.3 x 2.54 mm
