TheDarkKiwi/RoboCup/robocup cad/eak38/frontbumpercircle.SLDPRT

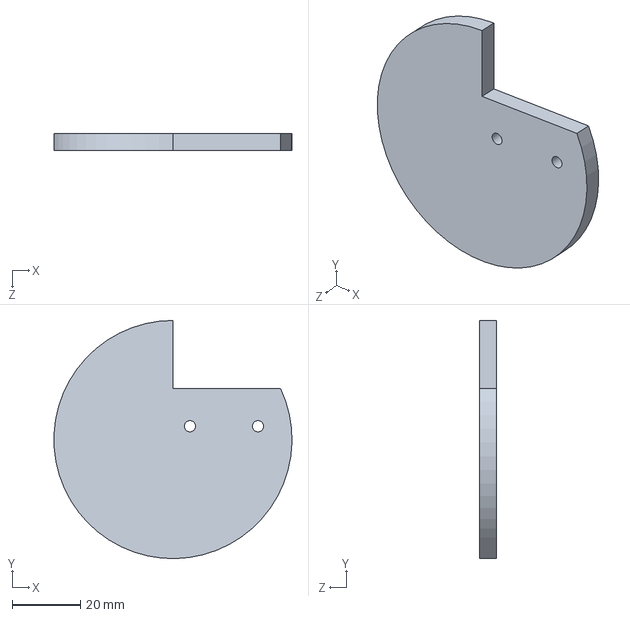
[picture p60: CAD file, 2024-12-19]
robocup cad/eak38/frontbumpercircle.SLDPRT
69.9 x 70.0 x 5.00 mm
