TheDarkKiwi/RoboCup/robocup cad/DLparts/herculex-1.snapshot.1/bracket/DRB-0004.step

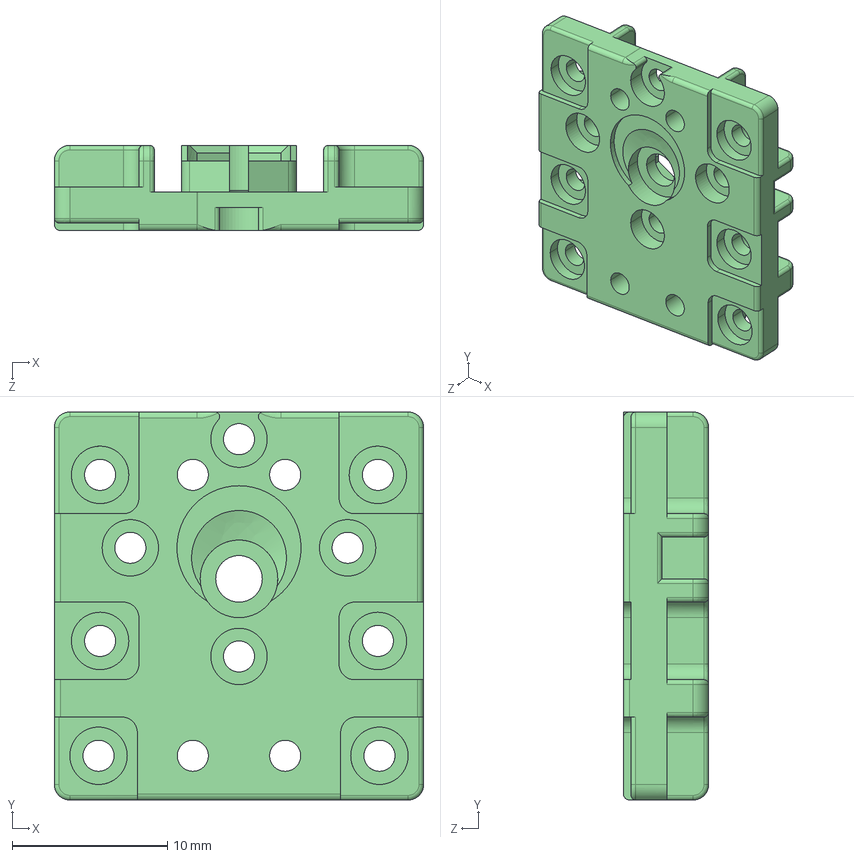
[picture p61: CAD file, 2024-12-19]
robocup cad/DLparts/herculex-1.snapshot.1/bracket/DRB-0004.step
23.8 x 25.0 x 5.50 mm
