TheDarkKiwi/RoboCup/robocup cad/eak38/Door.SLDPRT

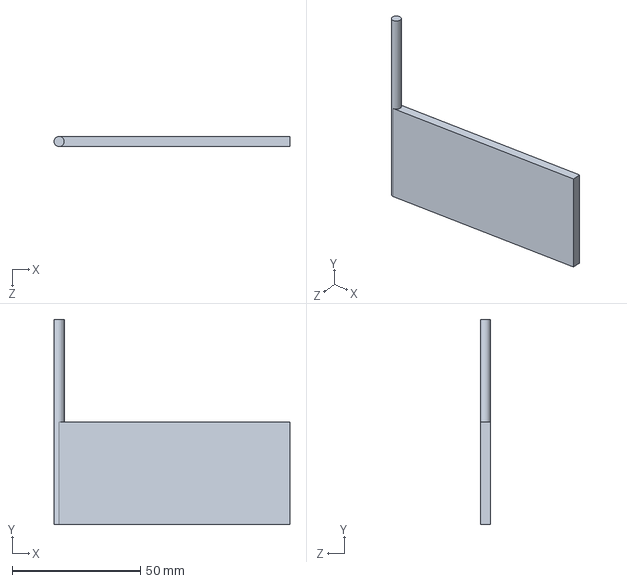
[picture p62: CAD file, 2024-12-19]
robocup cad/eak38/Door.SLDPRT
92.0 x 80.0 x 4.00 mm
