TheDarkKiwi/RoboCup/robocup cad/jed96/Internal passage way front ramp 2.SLDPRT

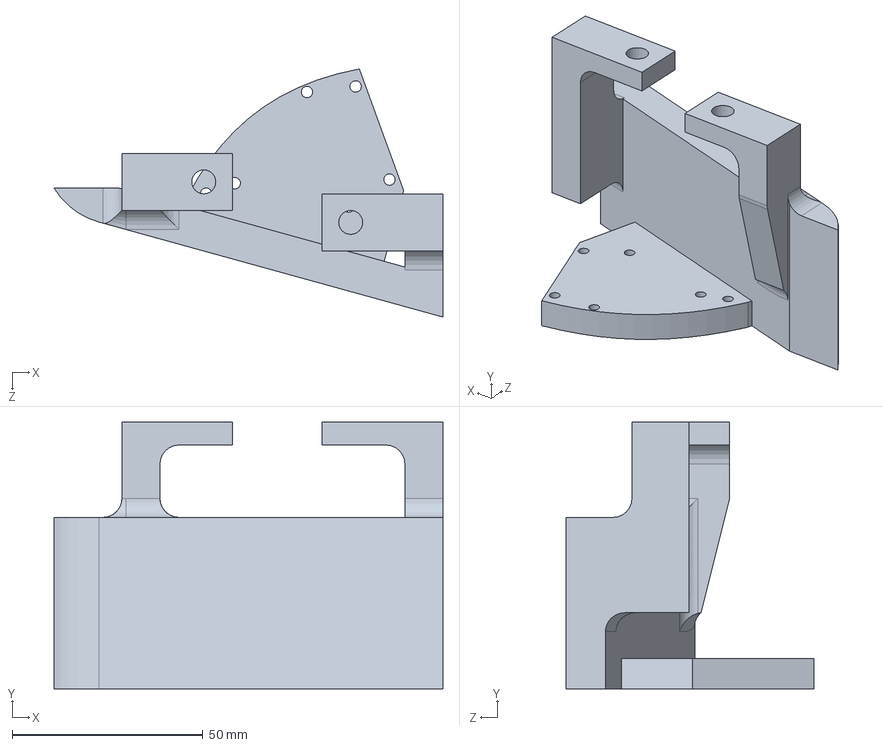
[picture p63: CAD file, 2024-12-19]
robocup cad/jed96/Internal passage way front ramp 2.SLDPRT
102.1 x 70.0 x 65.1 mm
