TheDarkKiwi/RoboCup/robocup cad/joint/Custom Side Plate 2.SLDPRT

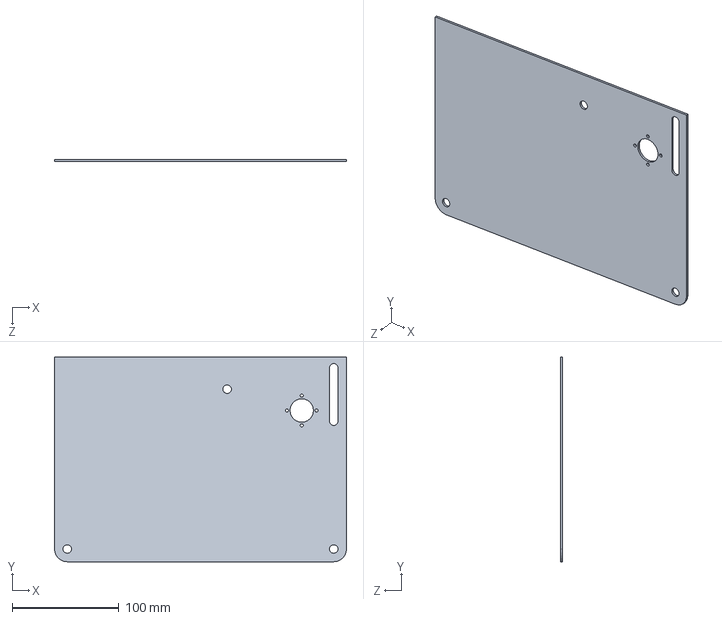
[picture p64: CAD file, 2024-12-19]
robocup cad/joint/Custom Side Plate 2.SLDPRT
274.0 x 192.0 x 2.00 mm
