TheDarkKiwi/RoboCup/robocup cad/WheelSliderEDIT2.SLDPRT

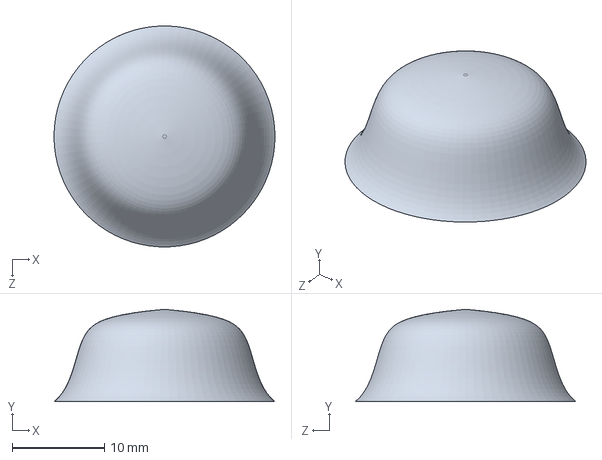
[picture p65: CAD file, 2024-12-19]
robocup cad/WheelSliderEDIT2.SLDPRT
24.0 x 10.0 x 24.0 mm
