TheDarkKiwi/RoboCup/robocup cad/dee21/62.5mm pulley.SLDPRT

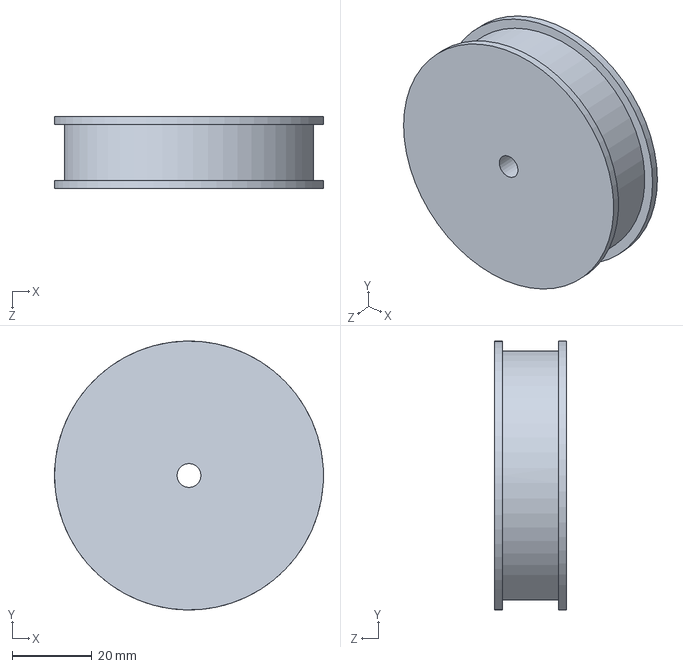
[picture p66: CAD file, 2024-12-19]
robocup cad/dee21/62.5mm pulley.SLDPRT
67.5 x 67.5 x 18.0 mm
