TheDarkKiwi/RoboCup/robocup cad/DLparts/herculex-1.snapshot.1/Joint/[DRJ-0011] Bushing Set_female.step

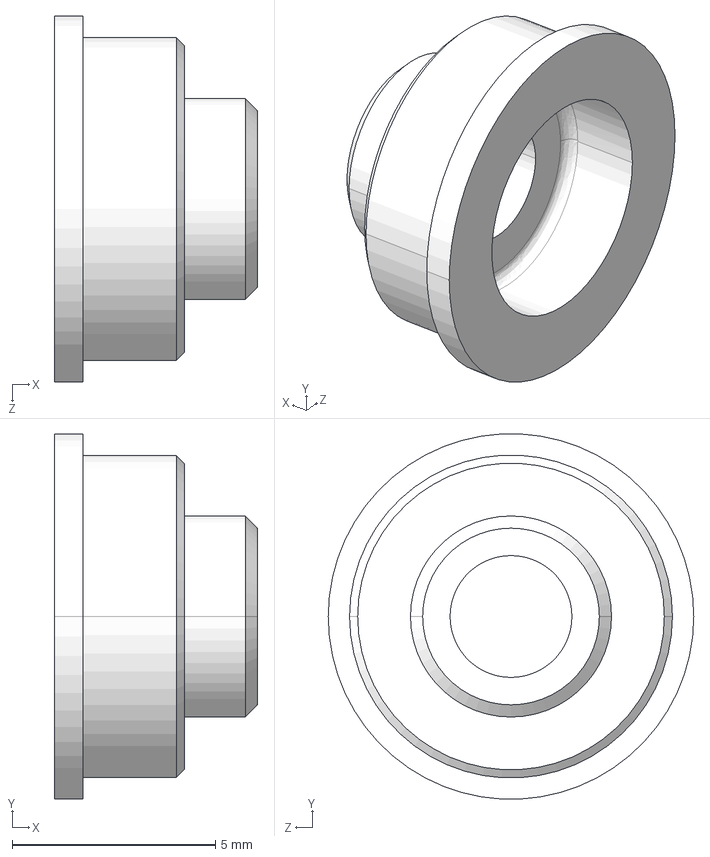
[picture p68: CAD file, 2024-12-19]
robocup cad/DLparts/herculex-1.snapshot.1/Joint/[DRJ-0011] Bushing Set_female.step
5.00 x 8.99 x 9.00 mm
