TheDarkKiwi/RoboCup/robocup cad/eak38/smartservobracket.SLDPRT

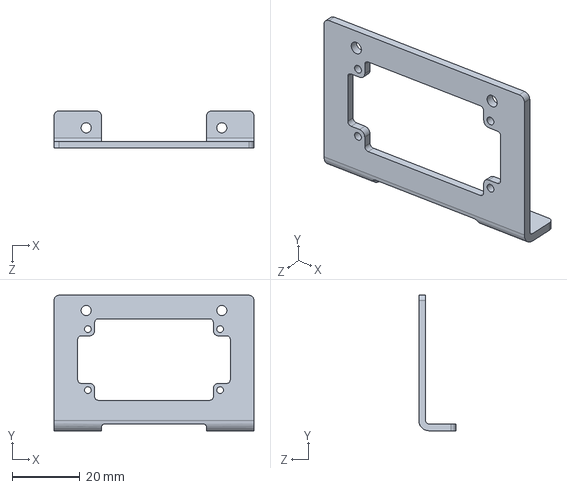
[picture p69: CAD file, 2024-12-19]
robocup cad/eak38/smartservobracket.SLDPRT
59.0 x 40.0 x 11.0 mm
