TheDarkKiwi/RoboCup/robocup cad/jed96/Large_wheel_true.SLDPRT

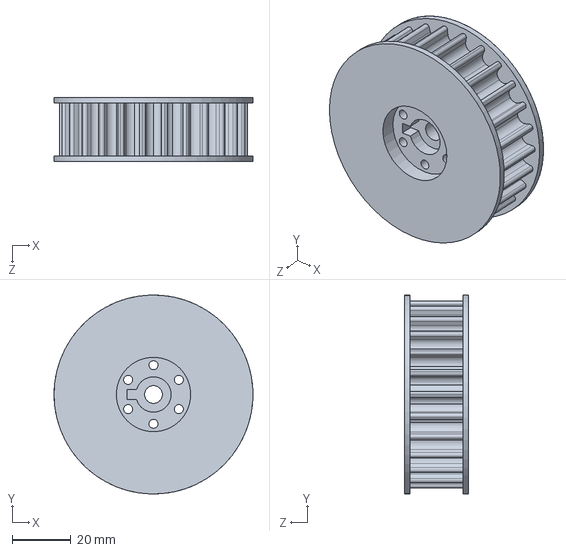
[picture p70: CAD file, 2024-12-19]
robocup cad/jed96/Large_wheel_true.SLDPRT
68.0 x 68.0 x 22.0 mm
