TheDarkKiwi/RoboCup/robocup cad/joint/Target Weight.SLDPRT

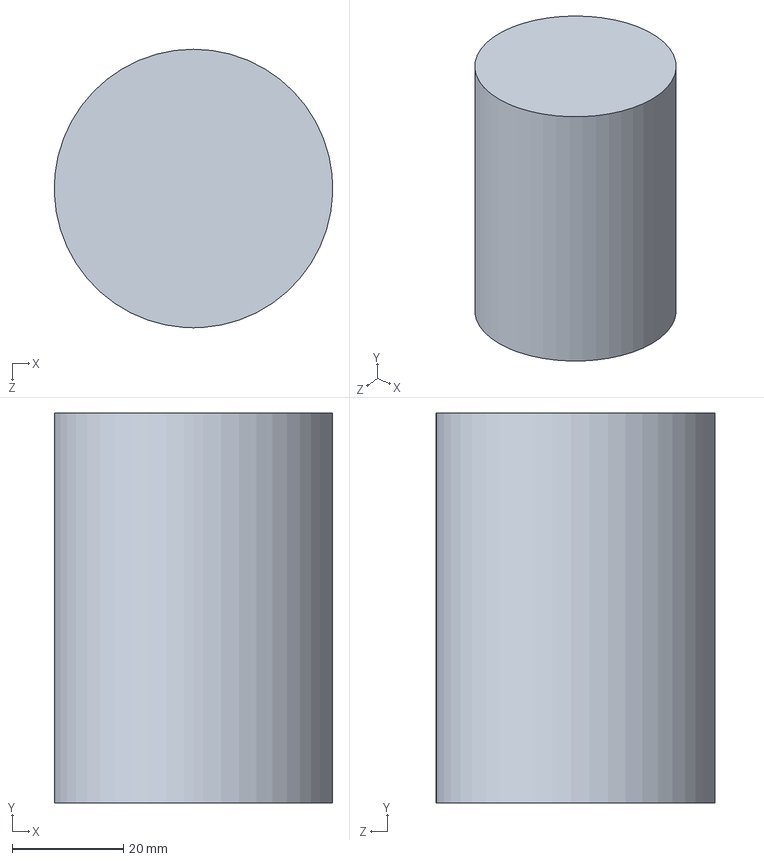
[picture p71: CAD file, 2024-12-19]
robocup cad/joint/Target Weight.SLDPRT
50.0 x 70.0 x 50.0 mm
