TheDarkKiwi/RoboCup/robocup cad/dee21/Drive Motor.SLDPRT

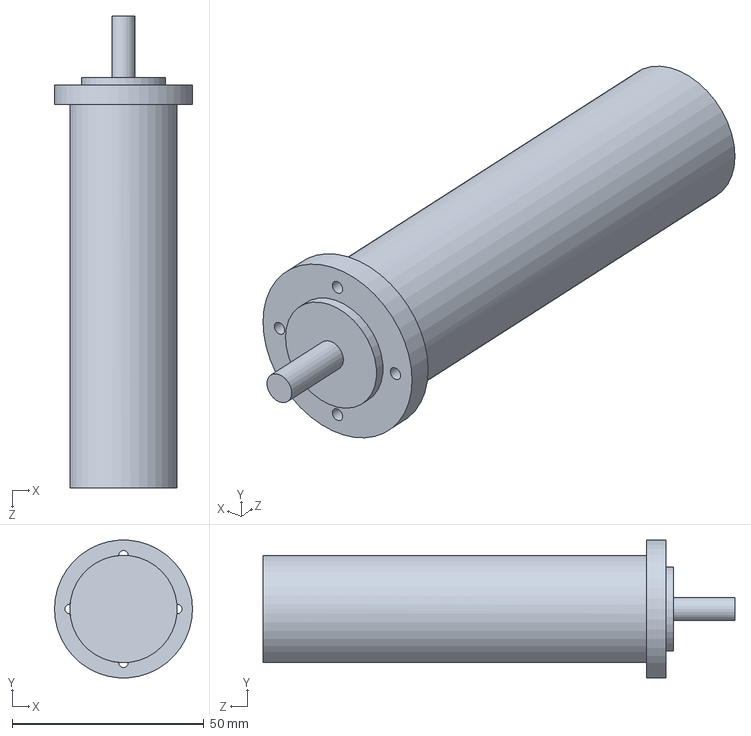
[picture p72: CAD file, 2024-12-19]
robocup cad/dee21/Drive Motor.SLDPRT
36.0 x 35.9 x 123.0 mm
