TheDarkKiwi/RoboCup/robocup cad/DLparts/herculex-1.snapshot.1/Joint/[DRJ-0011] Bushing Set_male.step

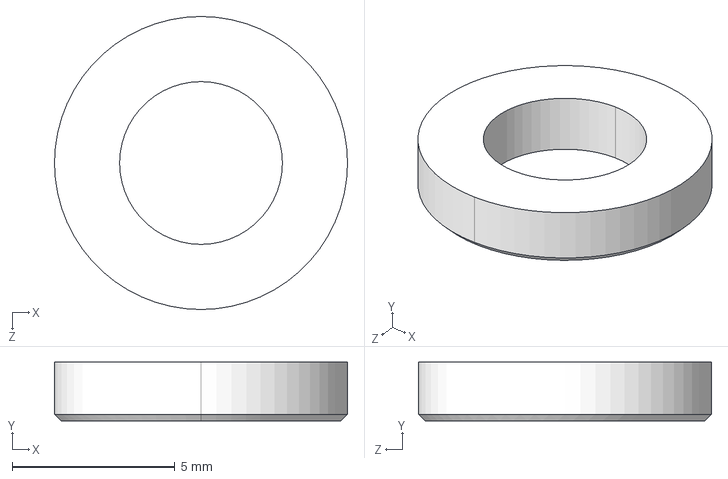
[picture p74: CAD file, 2024-12-19]
robocup cad/DLparts/herculex-1.snapshot.1/Joint/[DRJ-0011] Bushing Set_male.step
9.00 x 1.80 x 9.00 mm
