TheDarkKiwi/RoboCup/robocup cad/jed96/servo mag arm 1.SLDPRT

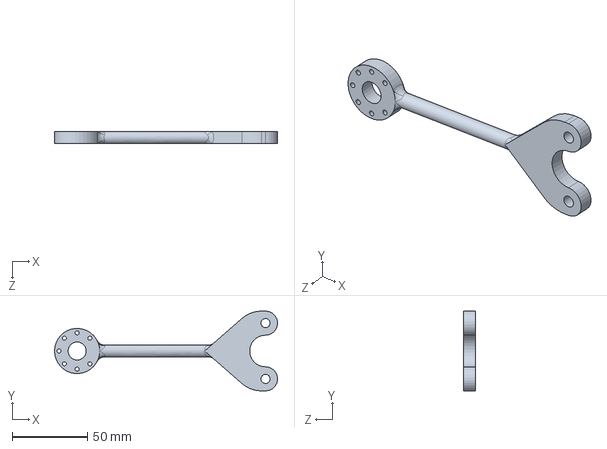
[picture p75: CAD file, 2024-12-19]
robocup cad/jed96/servo mag arm 1.SLDPRT
147.9 x 53.0 x 8.00 mm
