TheDarkKiwi/RoboCup/robocup cad/DLparts/herculex-1.snapshot.1/Joint/DRJ-0008.step

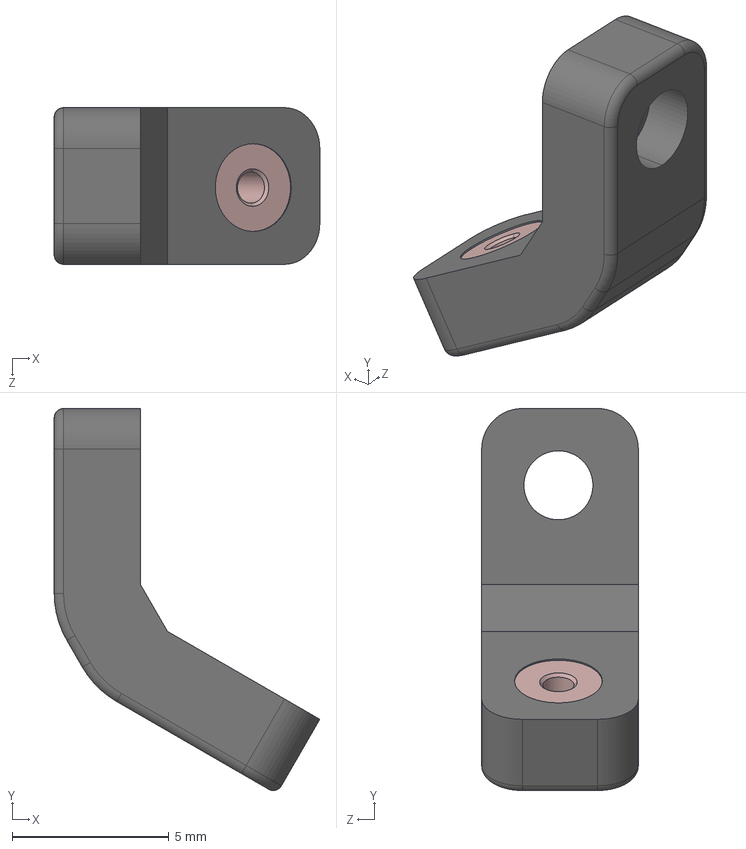
[picture p77: CAD file, 2024-12-19]
robocup cad/DLparts/herculex-1.snapshot.1/Joint/DRJ-0008.step
8.48 x 12.2 x 5.00 mm
