TheDarkKiwi/RoboCup/robocup cad/joint/50x 224 plate.SLDPRT

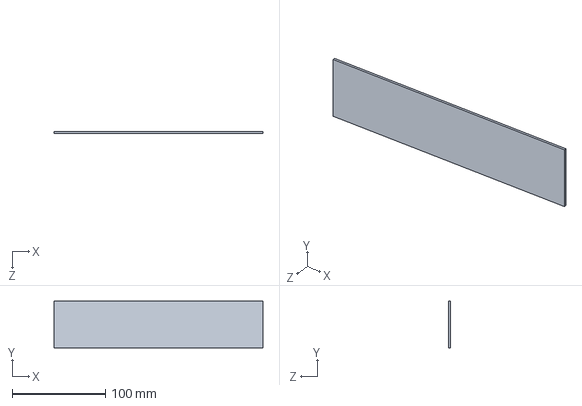
[picture p78: CAD file, 2024-12-19]
robocup cad/joint/50x 224 plate.SLDPRT
224.0 x 50.0 x 2.00 mm
