TheDarkKiwi/RoboCup/robocup cad/dee21/180x180 plate.SLDPRT

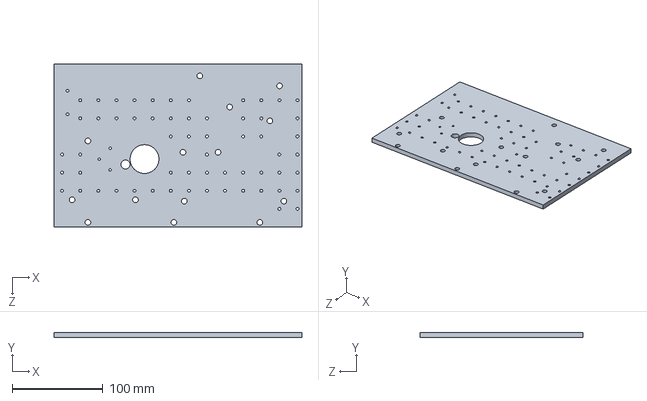
[picture p79: CAD file, 2024-12-19]
robocup cad/dee21/180x180 plate.SLDPRT
274.0 x 6.00 x 180.0 mm
