TheDarkKiwi/RoboCup/robocup cad/jed96/Internal passage way sensor part.SLDPRT

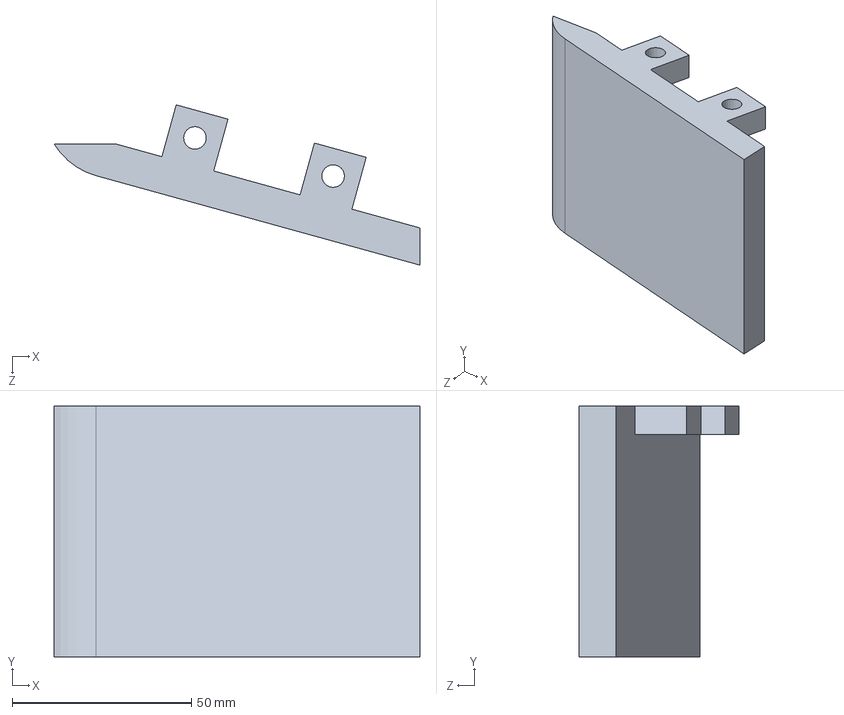
[picture p82: CAD file, 2024-12-19]
robocup cad/jed96/Internal passage way sensor part.SLDPRT
102.1 x 70.0 x 44.7 mm
