TheDarkKiwi/RoboCup/robocup cad/joint/Supplied Side Plate.SLDPRT

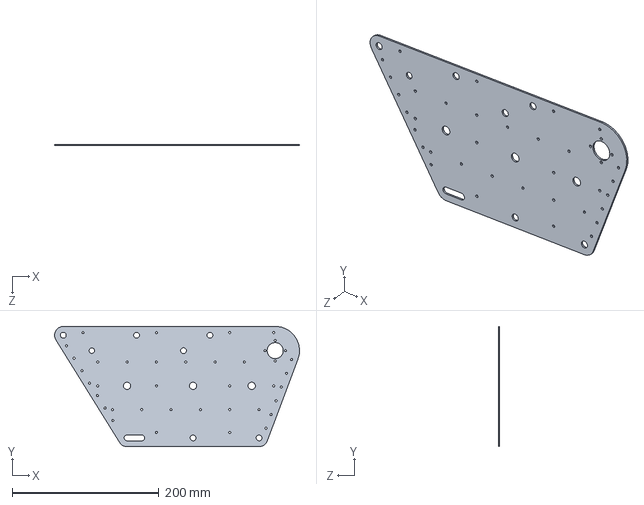
[picture p83: CAD file, 2024-12-19]
robocup cad/joint/Supplied Side Plate.SLDPRT
334.1 x 164.2 x 2.00 mm
