TheDarkKiwi/RoboCup/robocup cad/dee21/Belt1-1.SLDPRT

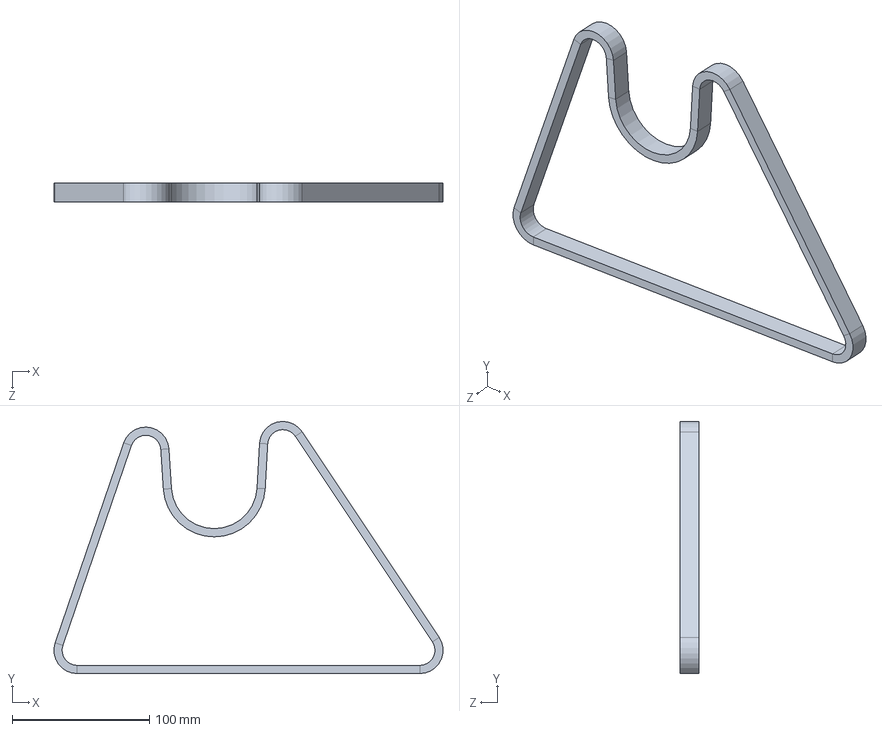
[picture p84: CAD file, 2024-12-19]
robocup cad/dee21/Belt1-1.SLDPRT
283.8 x 184.0 x 14.0 mm
