TheDarkKiwi/RoboCup/robocup cad/joint/HXT12k.IGS

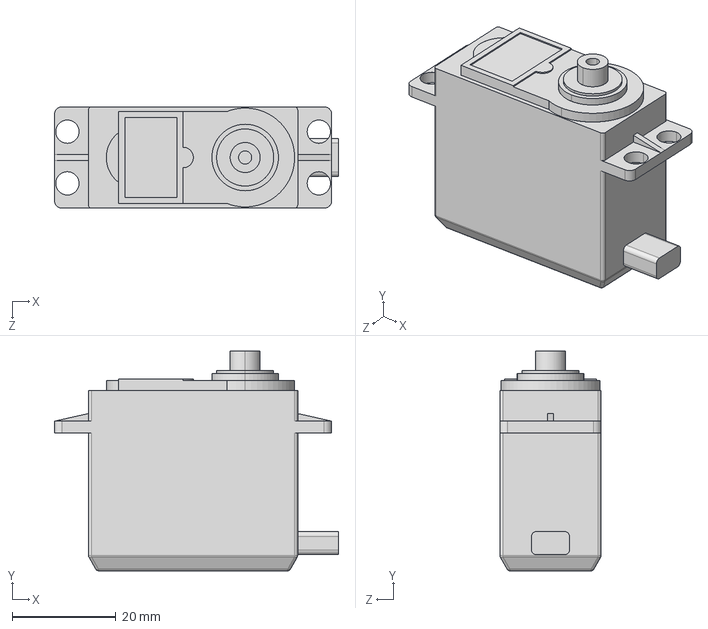
[picture p87: CAD file, 2024-12-19]
robocup cad/joint/HXT12k.IGS
54.9 x 42.4 x 19.6 mm
