TheDarkKiwi/RoboCup/robocup cad/dee21/Target Weight_PIMPED.SLDPRT

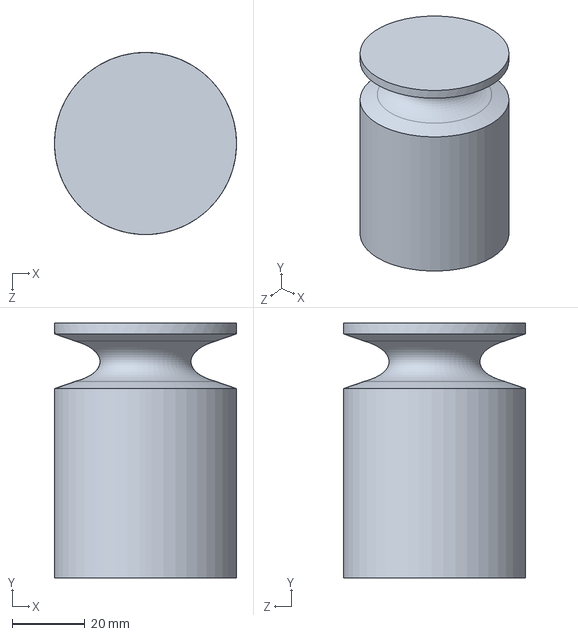
[picture p88: CAD file, 2024-12-19]
robocup cad/dee21/Target Weight_PIMPED.SLDPRT
50.0 x 70.0 x 50.0 mm
