TheDarkKiwi/RoboCup/robocup cad/jed96/belt sled8mm.SLDPRT

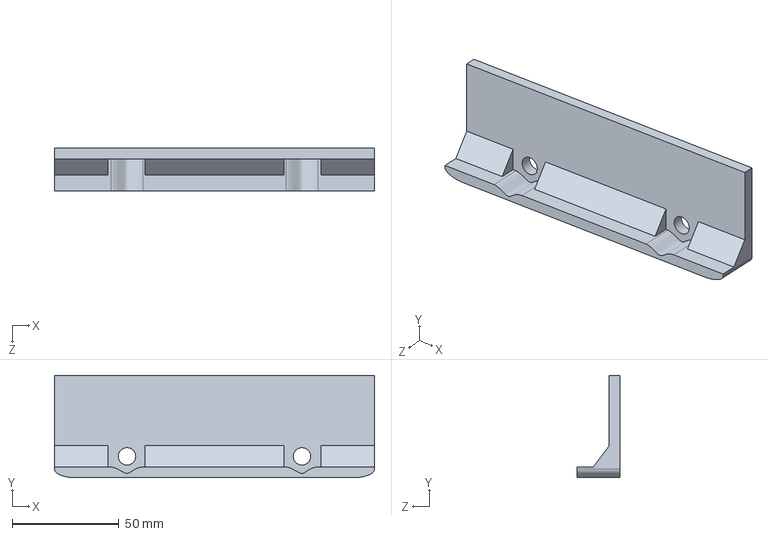
[picture p90: CAD file, 2024-12-19]
robocup cad/jed96/belt sled8mm.SLDPRT
150.0 x 48.0 x 20.0 mm
