TheDarkKiwi/RoboCup/robocup cad/joint/mag mount new.SLDPRT

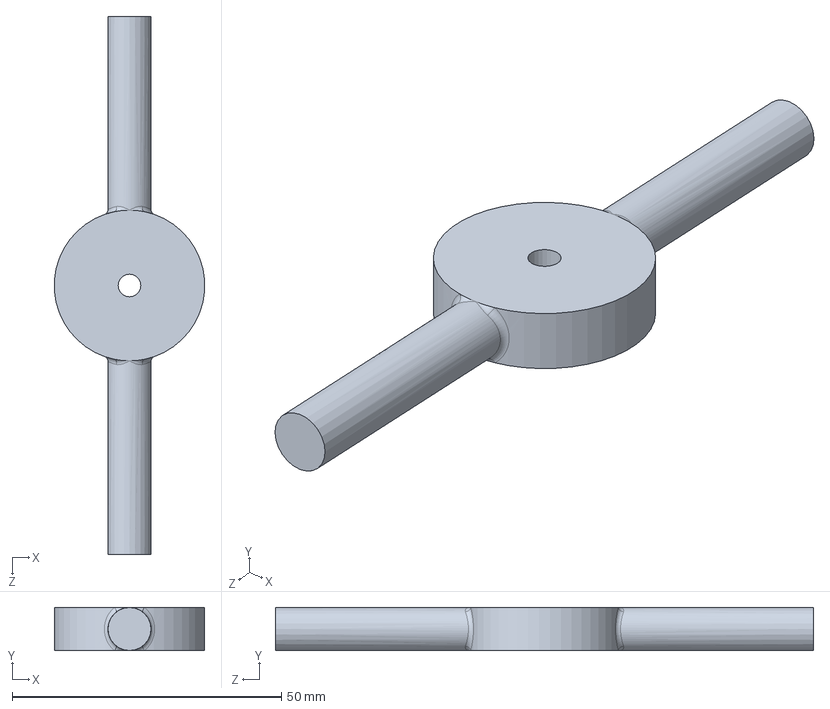
[picture p91: CAD file, 2024-12-19]
robocup cad/joint/mag mount new.SLDPRT
27.9 x 8.00 x 100.0 mm
