TheDarkKiwi/RoboCup/robocup cad/jed96/servowallmount2.SLDPRT

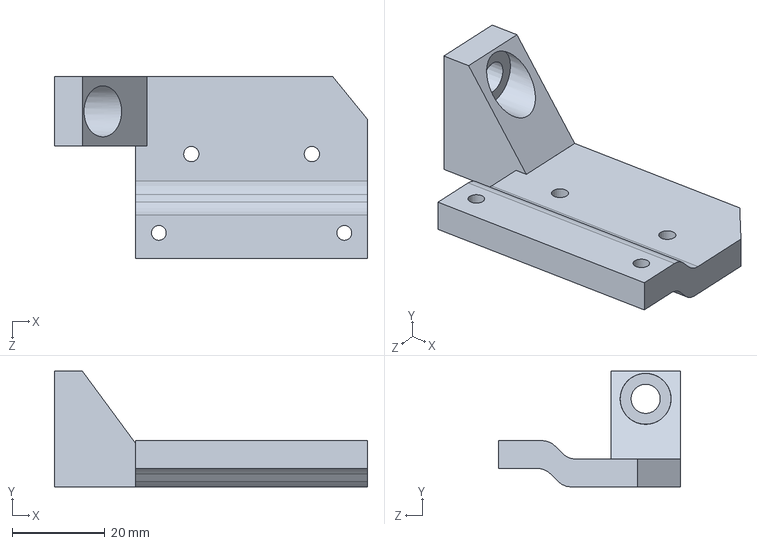
[picture p92: CAD file, 2024-12-19]
robocup cad/jed96/servowallmount2.SLDPRT
67.5 x 25.0 x 39.2 mm
