TheDarkKiwi/RoboCup/robocup cad/joint/1515 225mm.SLDPRT

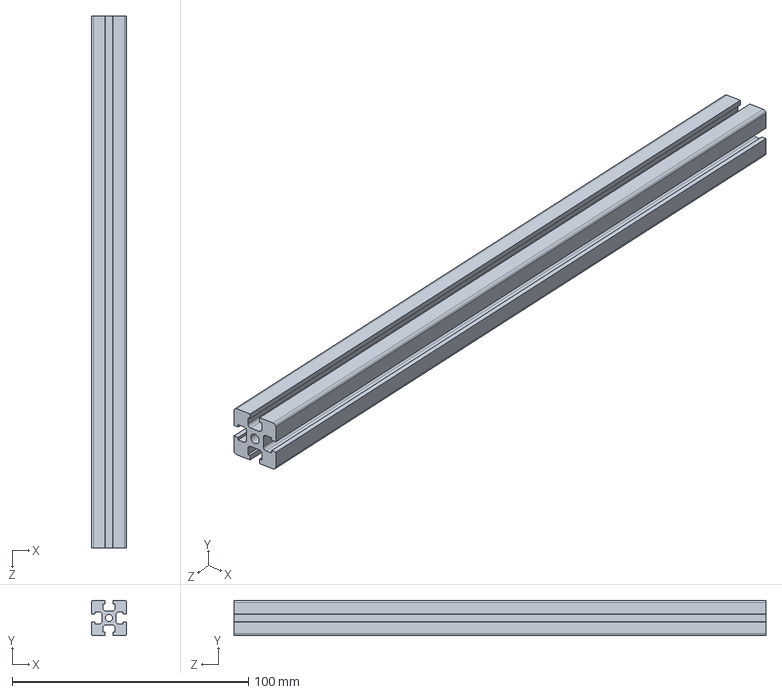
[picture p93: CAD file, 2024-12-19]
robocup cad/joint/1515 225mm.SLDPRT
15.0 x 15.0 x 225.0 mm
