TheDarkKiwi/RoboCup/robocup cad/dee21/side2top.SLDPRT

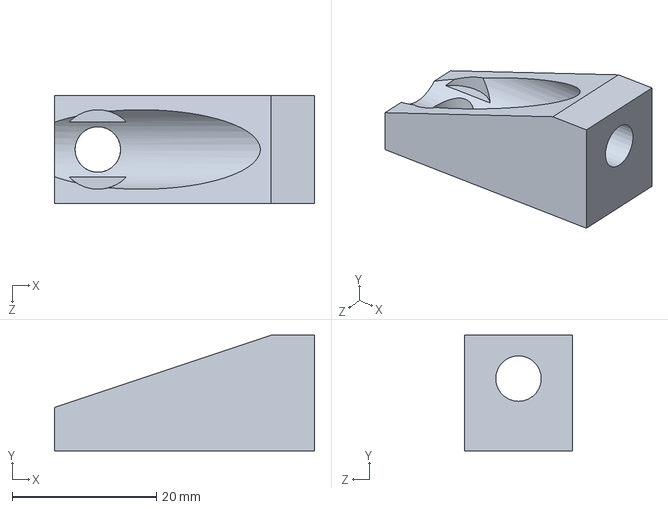
[picture p94: CAD file, 2024-12-19]
robocup cad/dee21/side2top.SLDPRT
36.0 x 16.0 x 15.0 mm
