TheDarkKiwi/RoboCup/robocup cad/jed96/Internal passage way front ramp.SLDPRT

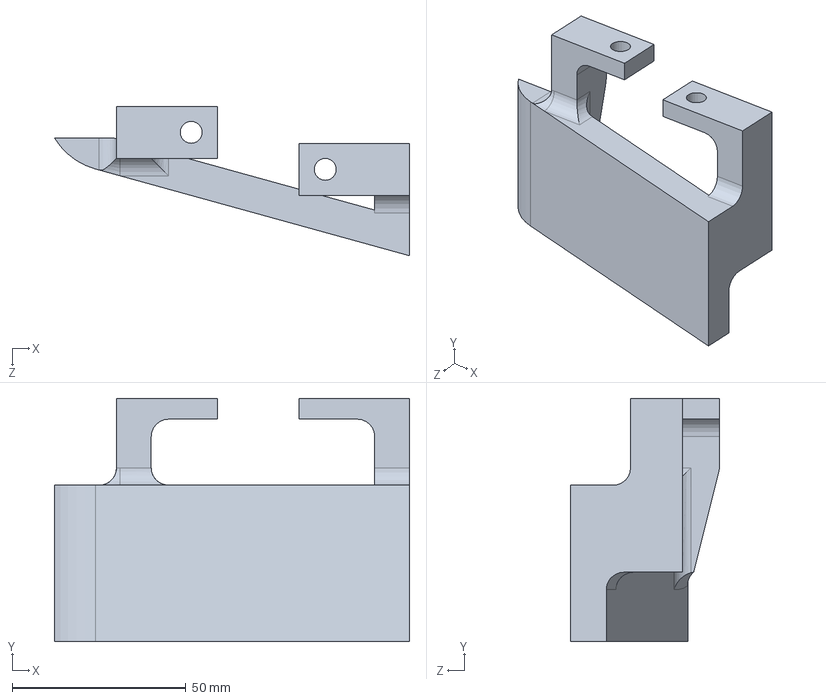
[picture p95: CAD file, 2024-12-19]
robocup cad/jed96/Internal passage way front ramp.SLDPRT
102.1 x 70.0 x 43.0 mm
