TheDarkKiwi/RoboCup/robocup cad/dee21/side2collection2.SLDPRT

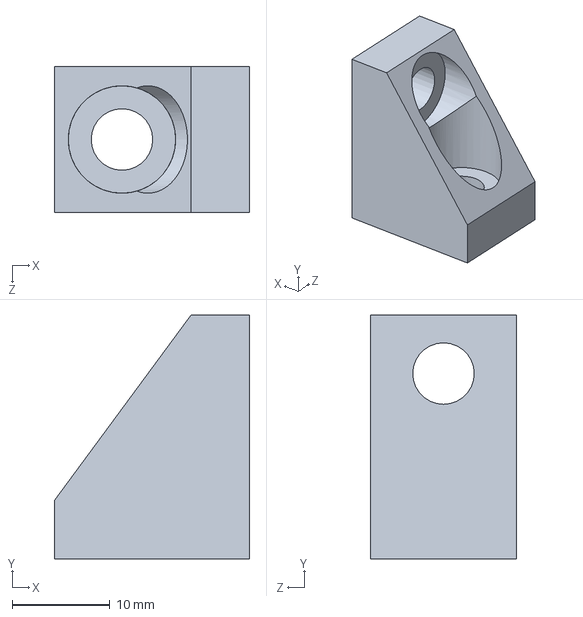
[picture p96: CAD file, 2024-12-19]
robocup cad/dee21/side2collection2.SLDPRT
20.0 x 25.0 x 15.0 mm
