TheDarkKiwi/RoboCup/robocup cad/jed96/Internal passage way.SLDPRT

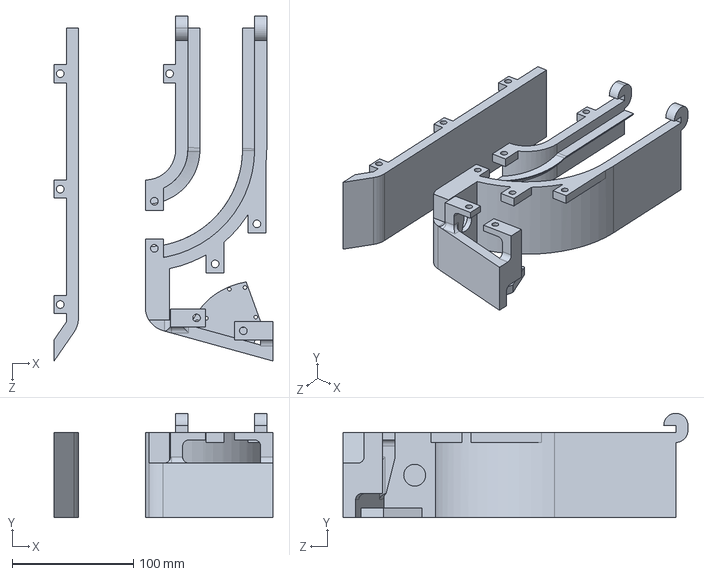
[picture p97: CAD file, 2024-12-19]
robocup cad/jed96/Internal passage way.SLDPRT
180.0 x 86.0 x 284.0 mm
