TheDarkKiwi/RoboCup/robocup cad/joint/184x274 plate.SLDPRT

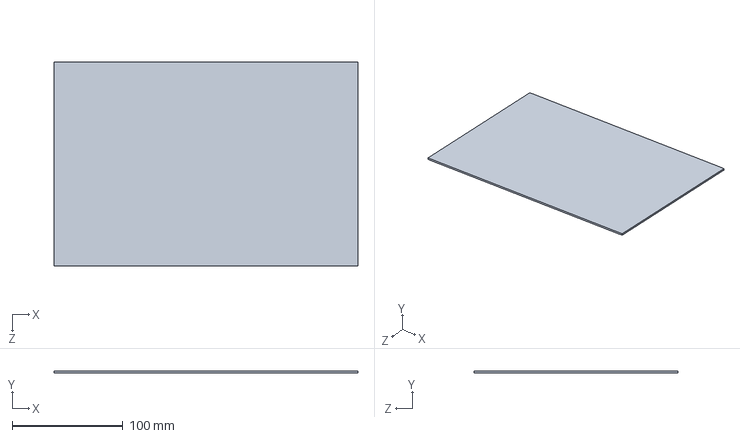
[picture p98: CAD file, 2024-12-19]
robocup cad/joint/184x274 plate.SLDPRT
274.0 x 2.00 x 184.0 mm
