TheDarkKiwi/RoboCup/robocup cad/dee21/servowallmount.SLDPRT

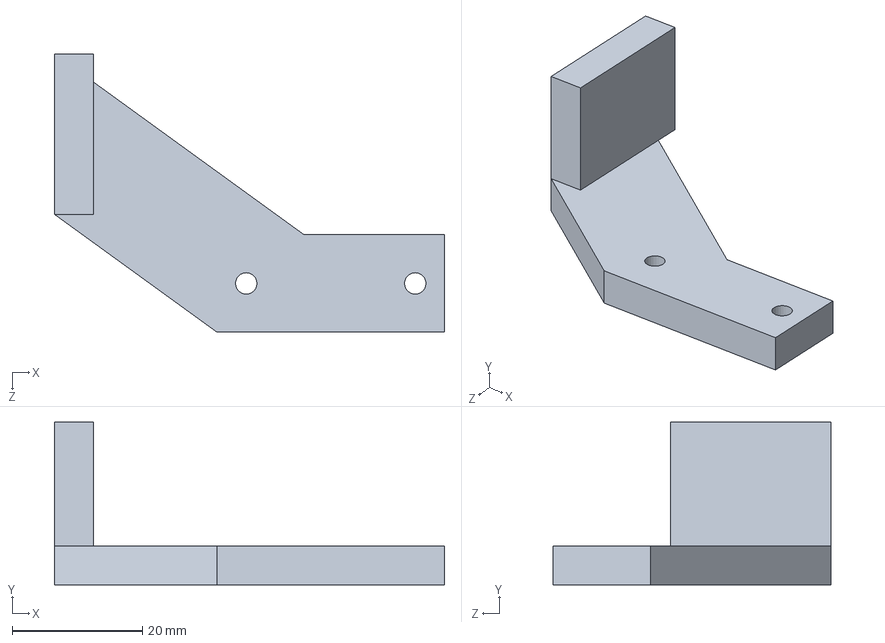
[picture p99: CAD file, 2024-12-19]
robocup cad/dee21/servowallmount.SLDPRT
60.0 x 25.0 x 42.8 mm
