TheDarkKiwi/RoboCup/robocup cad/jed96/184x274 plate.SLDPRT

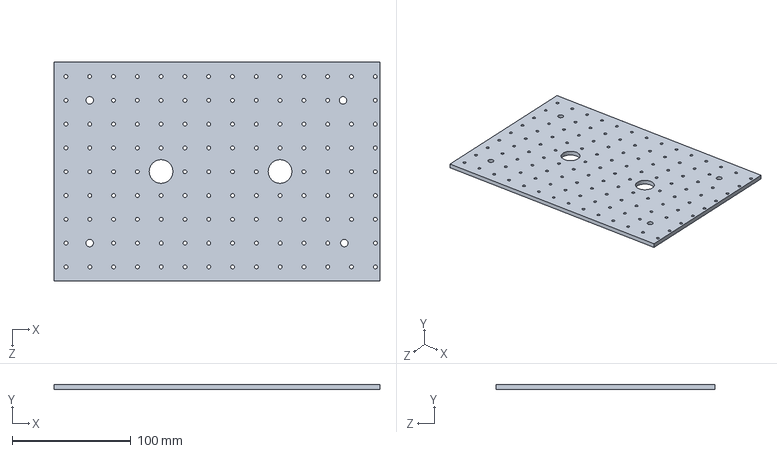
[picture p100: CAD file, 2024-12-19]
robocup cad/jed96/184x274 plate.SLDPRT
274.0 x 4.50 x 184.0 mm
