TheDarkKiwi/RoboCup/robocup cad/joint/servo mag arm 1.SLDPRT

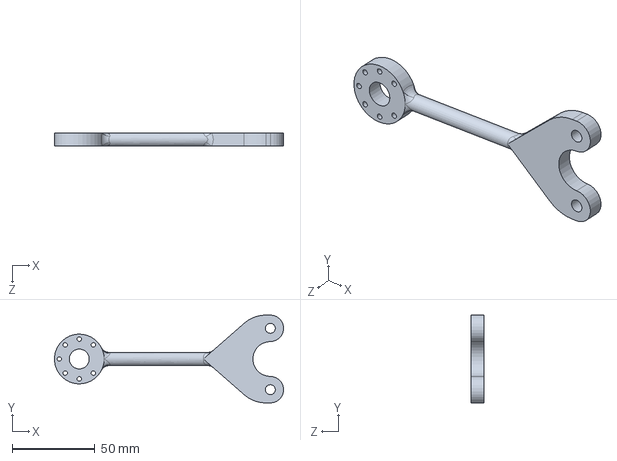
[picture p101: CAD file, 2024-12-19]
robocup cad/joint/servo mag arm 1.SLDPRT
138.0 x 53.0 x 8.00 mm
