TheDarkKiwi/RoboCup/robocup cad/dee21/Internal passage way 1.STL

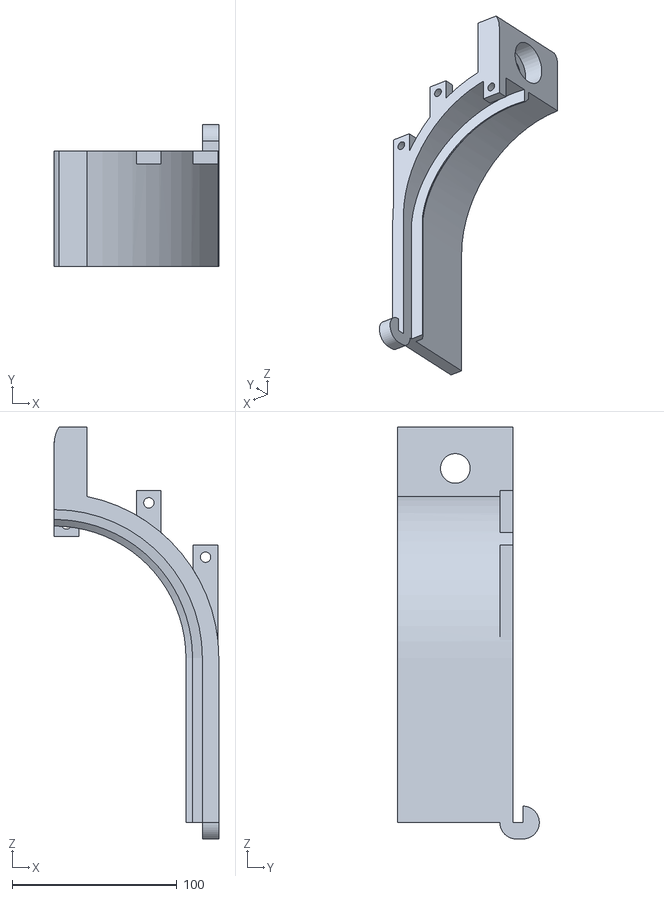
[picture p102: CAD file, 2024-12-19]
robocup cad/dee21/Internal passage way 1.STL
100.0 x 86.0 x 250.1
