TheDarkKiwi/RoboCup/robocup cad/dee21/Door2.SLDPRT

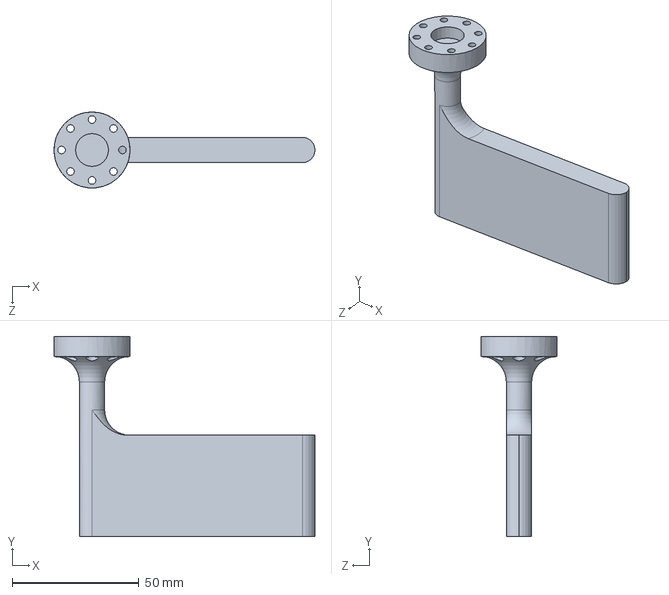
[picture p103: CAD file, 2024-12-19]
robocup cad/dee21/Door2.SLDPRT
103.0 x 79.0 x 30.0 mm
