TheDarkKiwi/RoboCup/robocup cad/joint/90x180 plate.SLDPRT

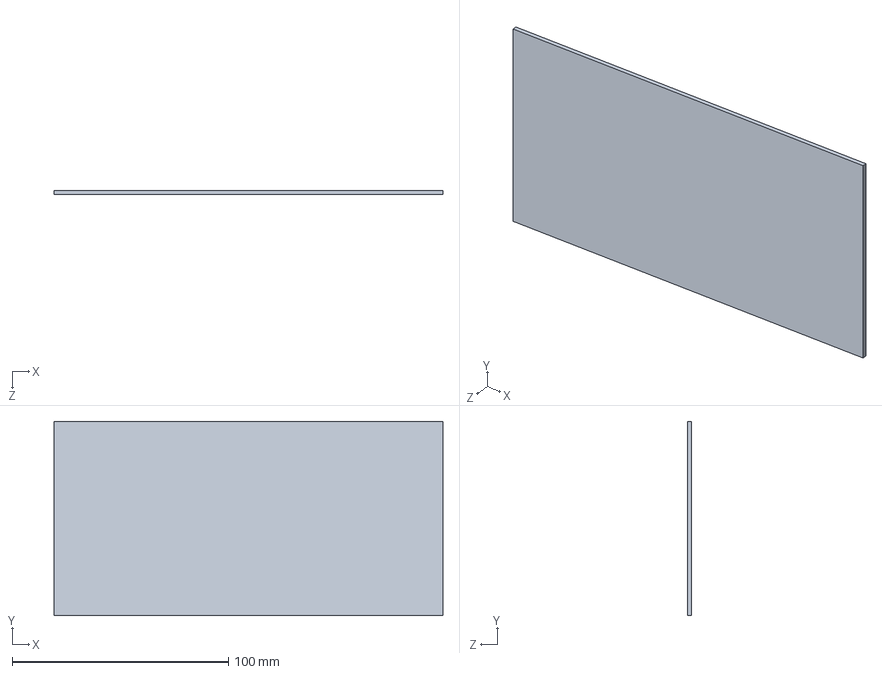
[picture p104: CAD file, 2024-12-19]
robocup cad/joint/90x180 plate.SLDPRT
180.0 x 90.0 x 2.00 mm
