TheDarkKiwi/RoboCup/robocup cad/joint/Wedge.SLDPRT

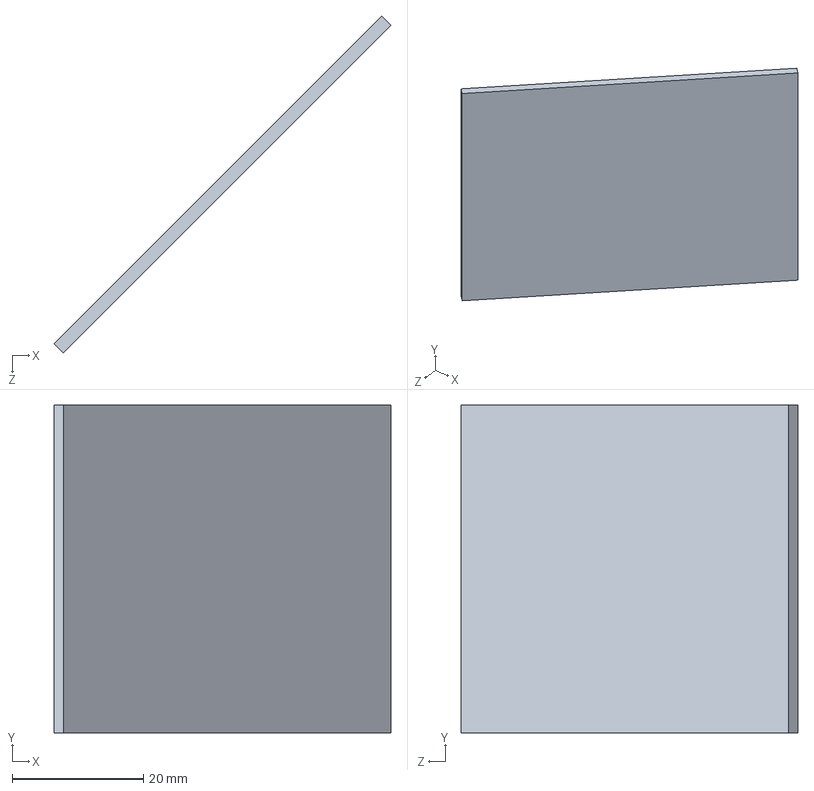
[picture p105: CAD file, 2024-12-19]
robocup cad/joint/Wedge.SLDPRT
51.4 x 50.0 x 51.4 mm
