TheDarkKiwi/RoboCup/robocup cad/joint/180x180 plate.SLDPRT

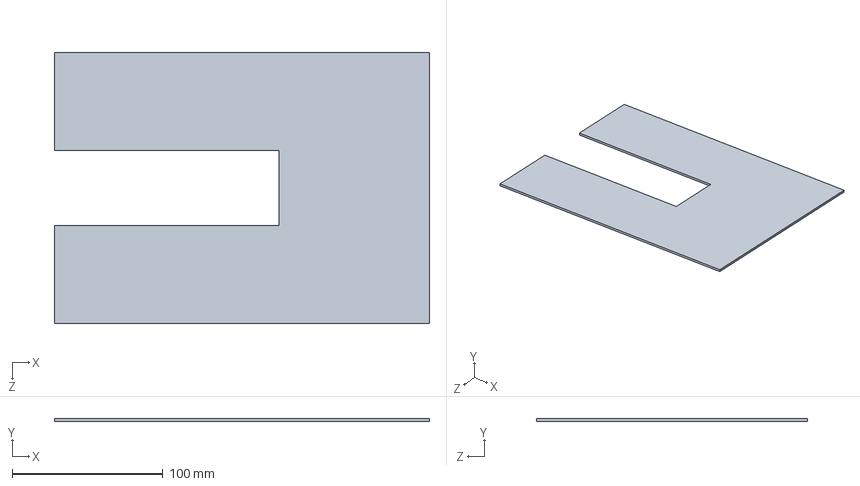
[picture p106: CAD file, 2024-12-19]
robocup cad/joint/180x180 plate.SLDPRT
248.8 x 2.00 x 180.0 mm
