TheDarkKiwi/RoboCup/robocup cad/jed96/corner bracket.SLDPRT

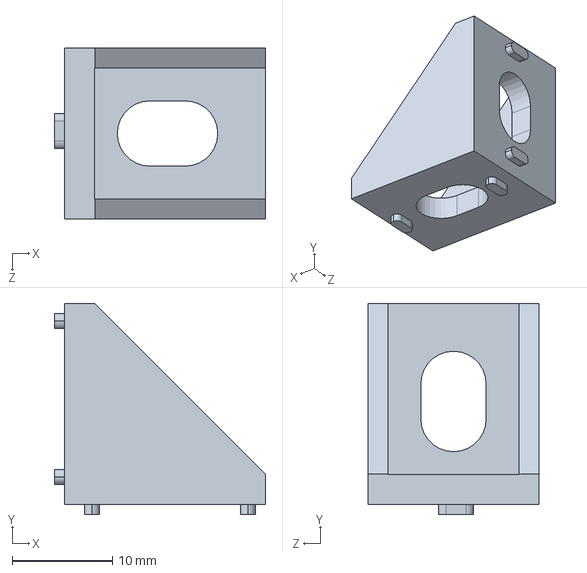
[picture p107: CAD file, 2024-12-19]
robocup cad/jed96/corner bracket.SLDPRT
21.0 x 21.0 x 17.0 mm
