TheDarkKiwi/RoboCup/robocup cad/joint/22mm pulley.SLDPRT

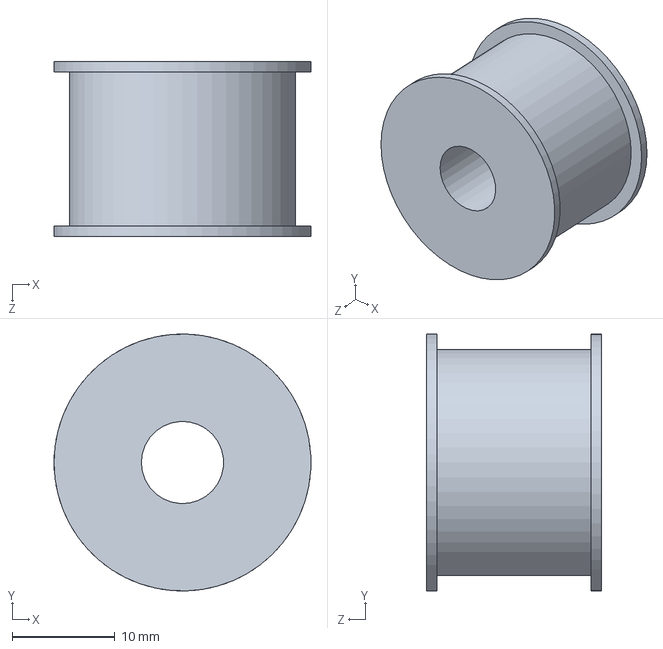
[picture p108: CAD file, 2024-12-19]
robocup cad/joint/22mm pulley.SLDPRT
25.0 x 25.0 x 17.0 mm
