TheDarkKiwi/RoboCup/robocup cad/jed96/Smart servo gate.SLDPRT

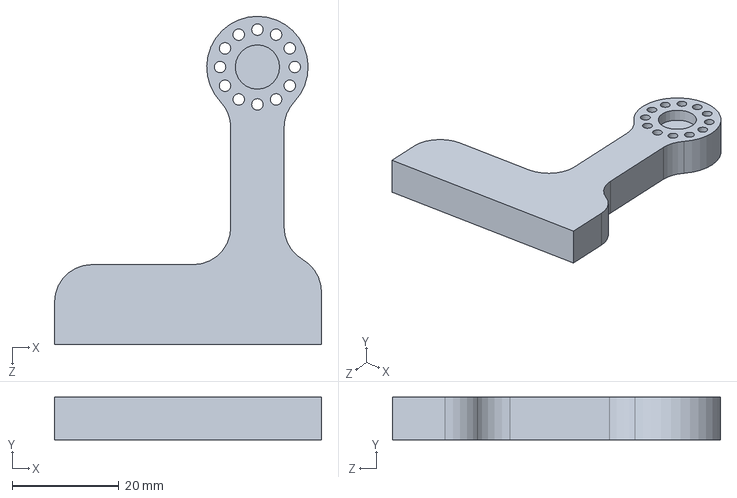
[picture p109: CAD file, 2024-12-19]
robocup cad/jed96/Smart servo gate.SLDPRT
50.0 x 8.00 x 61.5 mm
