TheDarkKiwi/RoboCup/robocup cad/joint/mag mount.SLDPRT

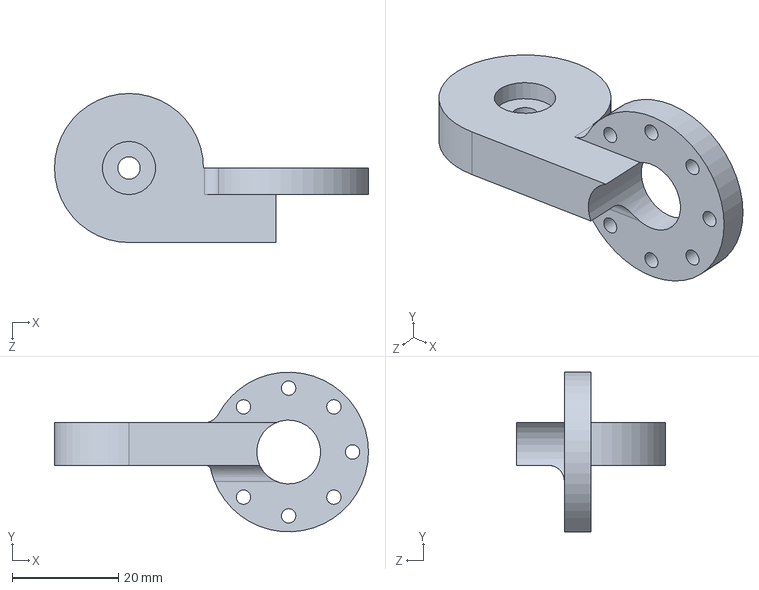
[picture p110: CAD file, 2024-12-19]
robocup cad/joint/mag mount.SLDPRT
59.0 x 30.0 x 28.0 mm
