TheDarkKiwi/RoboCup/robocup cad/dee21/side2collection.SLDPRT

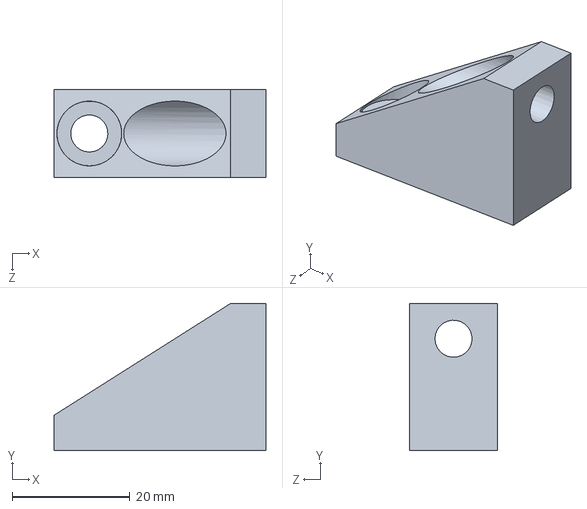
[picture p111: CAD file, 2024-12-19]
robocup cad/dee21/side2collection.SLDPRT
36.0 x 25.0 x 15.0 mm
