TheDarkKiwi/RoboCup/robocup cad/dee21/mag mount.SLDPRT

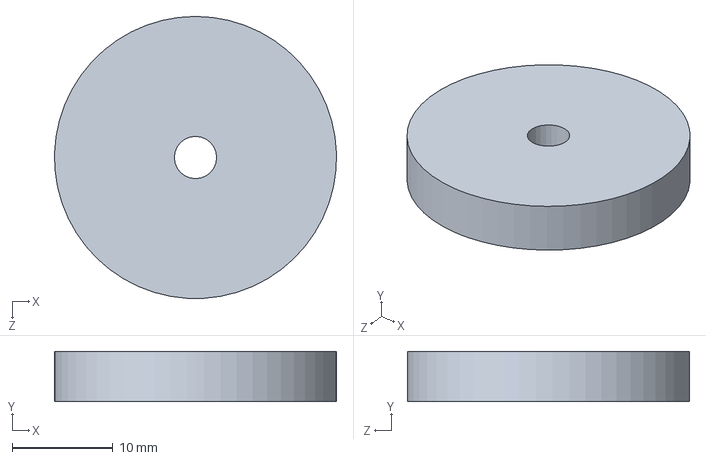
[picture p112: CAD file, 2024-12-19]
robocup cad/dee21/mag mount.SLDPRT
28.0 x 5.00 x 28.0 mm
