TheDarkKiwi/RoboCup/robocup cad/joint/30x30x30.SLDPRT

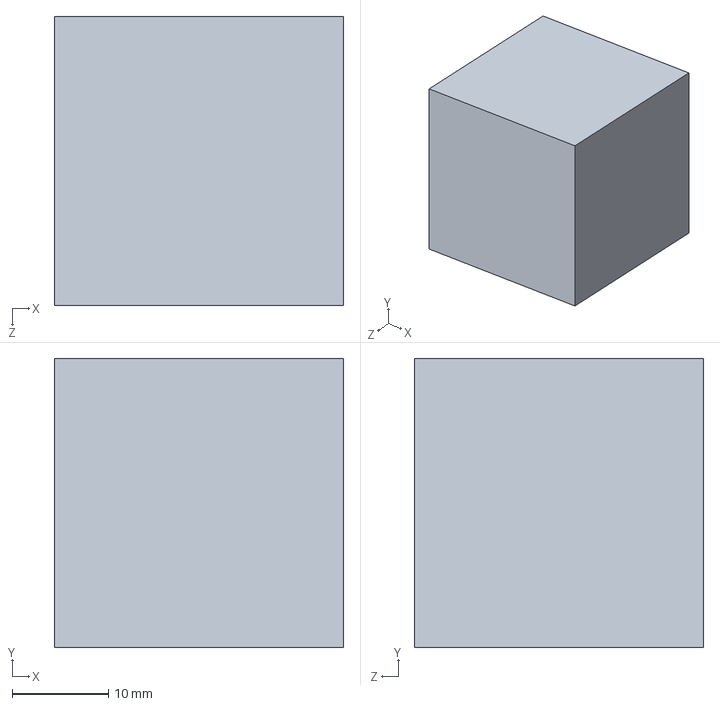
[picture p113: CAD file, 2024-12-19]
robocup cad/joint/30x30x30.SLDPRT
30.0 x 30.0 x 30.0 mm
