TheDarkKiwi/RoboCup/robocup cad/jed96/Side Guard foot.SLDPRT

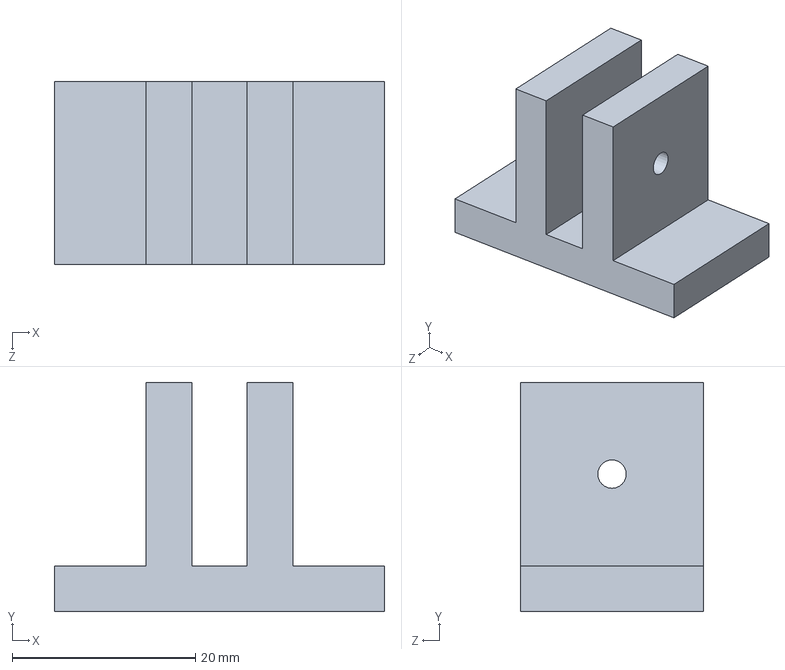
[picture p115: CAD file, 2024-12-19]
robocup cad/jed96/Side Guard foot.SLDPRT
36.0 x 25.0 x 20.0 mm
