TheDarkKiwi/RoboCup/robocup cad/dee21/Internal passage way 2.STL

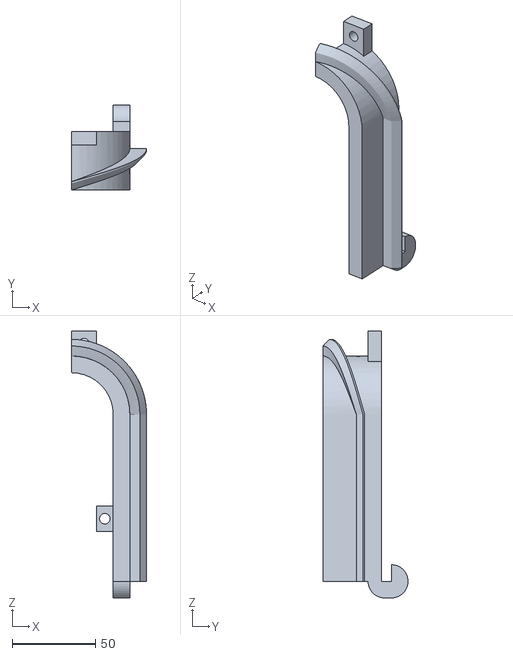
[picture p116: CAD file, 2024-12-19]
robocup cad/dee21/Internal passage way 2.STL
45.0 x 51.0 x 160.0
