TheDarkKiwi/RoboCup/robocup cad/jed96/Motor coupling.SLDPRT

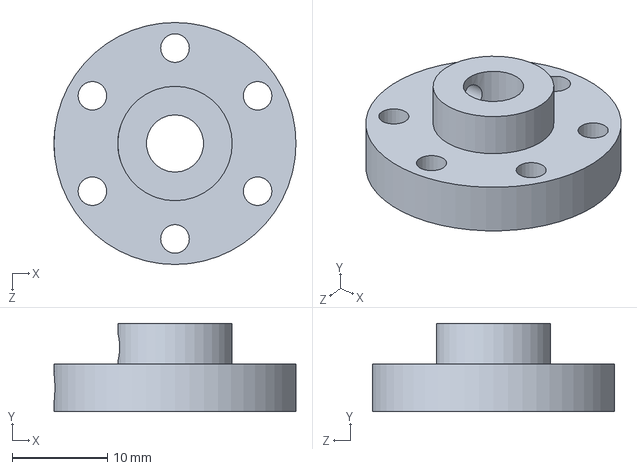
[picture p117: CAD file, 2024-12-19]
robocup cad/jed96/Motor coupling.SLDPRT
25.4 x 9.25 x 25.4 mm
