TheDarkKiwi/RoboCup/robocup cad/jed96/Side guard wall.SLDPRT

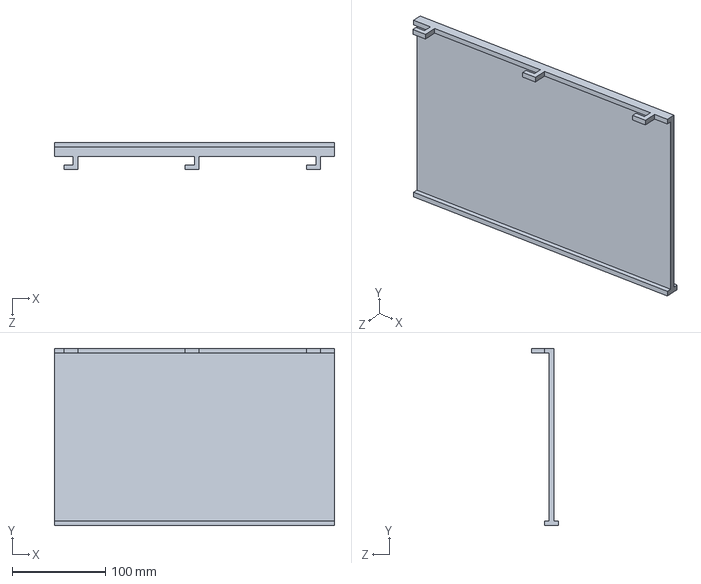
[picture p118: CAD file, 2024-12-19]
robocup cad/jed96/Side guard wall.SLDPRT
300.0 x 190.0 x 29.0 mm
