TheDarkKiwi/RoboCup/robocup cad/jed96/servo mag arm 2.SLDPRT

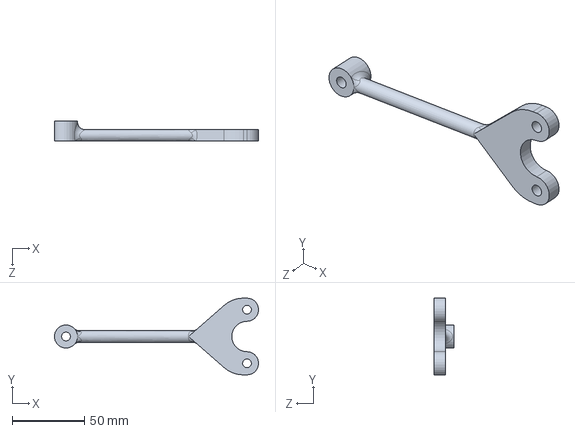
[picture p119: CAD file, 2024-12-19]
robocup cad/jed96/servo mag arm 2.SLDPRT
140.9 x 53.0 x 14.0 mm
