TheDarkKiwi/RoboCup/robocup cad/jed96/Side Guard base plate.SLDPRT

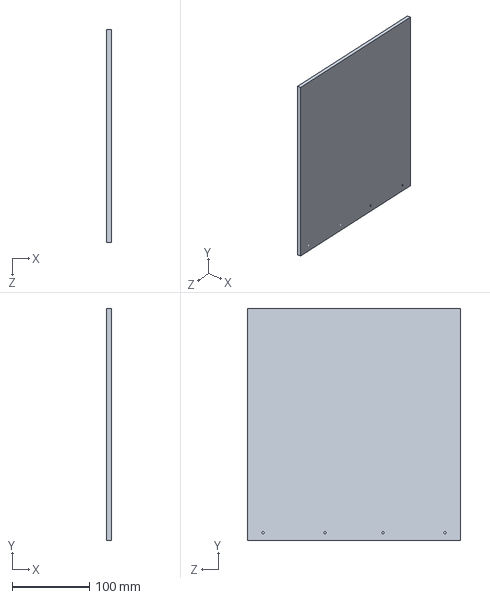
[picture p120: CAD file, 2024-12-19]
robocup cad/jed96/Side Guard base plate.SLDPRT
6.00 x 300.0 x 275.0 mm
