TheDarkKiwi/RoboCup/robocup cad/jed96/Internal passage way print test.SLDPRT

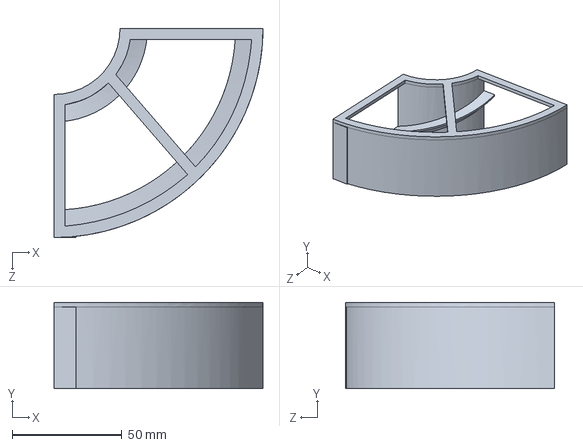
[picture p121: CAD file, 2024-12-19]
robocup cad/jed96/Internal passage way print test.SLDPRT
95.0 x 39.1 x 95.0 mm
