TheDarkKiwi/RoboCup/robocup cad/dee21/BeltOtherSide.SLDASM

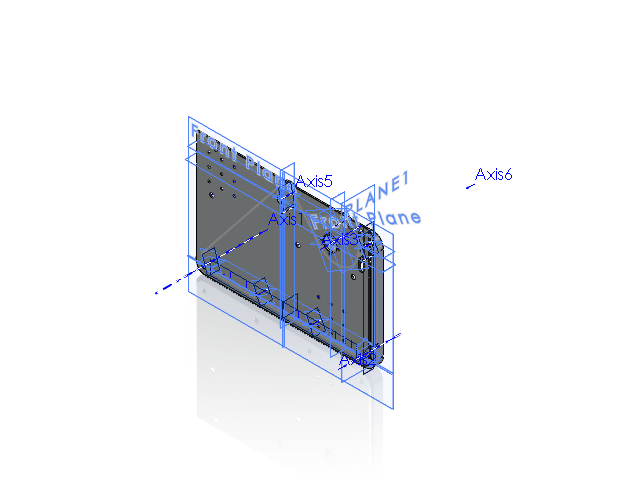
[picture p122: CAD file, 2024-12-19]
robocup cad/dee21/BeltOtherSide.SLDASM
22mm pulley x 6
62.5mm pulley
Custom Side Plate2
Skids
Belt1-1^BeltOtherSide
