TheDarkKiwi/RoboCup/robocup cad/joint/Belt.SLDASM

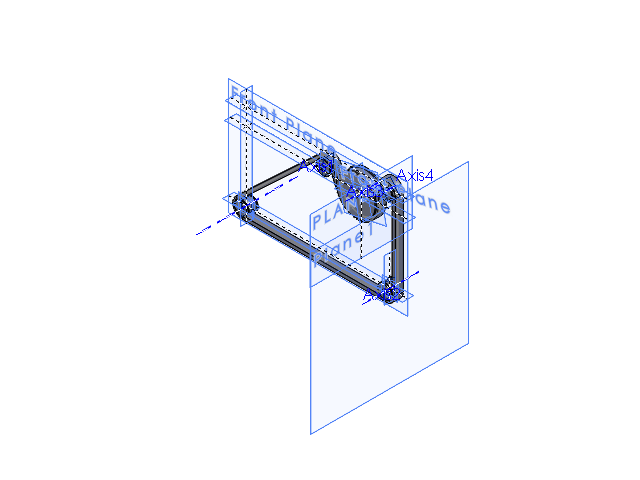
[picture p123: CAD file, 2024-12-19]
robocup cad/joint/Belt.SLDASM
22mm pulley x 4
62.5mm pulley
Belt1-1^Belt
