TheDarkKiwi/RoboCup/robocup cad/dee21/BeltOther.SLDASM

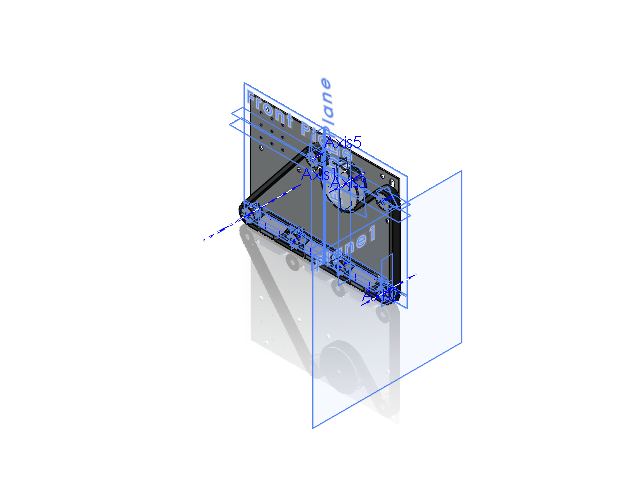
[picture p124: CAD file, 2024-12-19]
robocup cad/dee21/BeltOther.SLDASM
22mm pulley x 6
62.5mm pulley
Custom Side Plate
Skids
Belt1-1
