TheDarkKiwi/RoboCup/robocup cad/joint/BeltOther.SLDASM

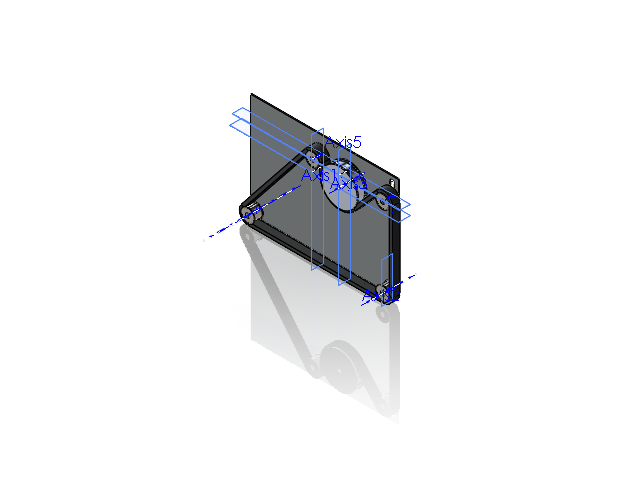
[picture p125: CAD file, 2024-12-19]
robocup cad/joint/BeltOther.SLDASM
22mm pulley x 4
62.5mm pulley
Custom Side Plate
Belt1-1
