TheDarkKiwi/RoboCup/robocup cad/joint/BeltOtherSide.SLDASM

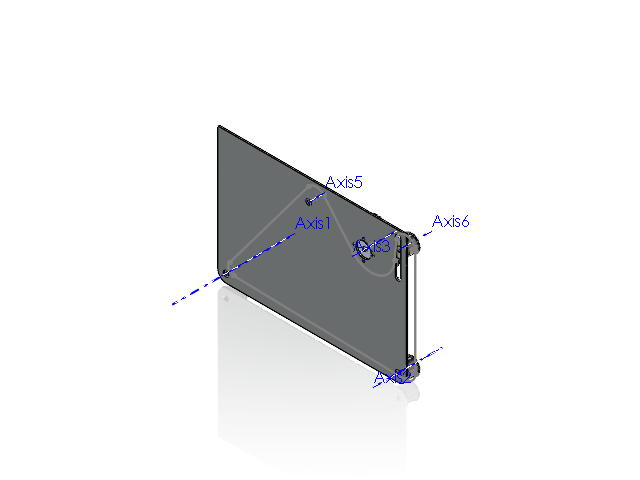
[picture p126: CAD file, 2024-12-19]
robocup cad/joint/BeltOtherSide.SLDASM
22mm pulley x 4
62.5mm pulley
Custom Side Plate2
Belt1-1^BeltOtherSide
