TheDarkKiwi/RoboCup/robocup cad/jed96/side guard assem.SLDASM

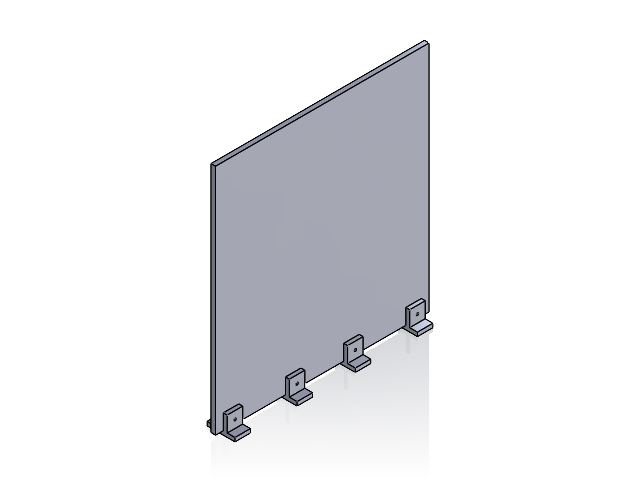
[picture p127: CAD file, 2024-12-19]
robocup cad/jed96/side guard assem.SLDASM
Side Guard base plate
Side Guard foot x 4
