TheDarkKiwi/RoboCup/robocup cad/jed96/[HerkuleX] DRS-010X.SLDASM

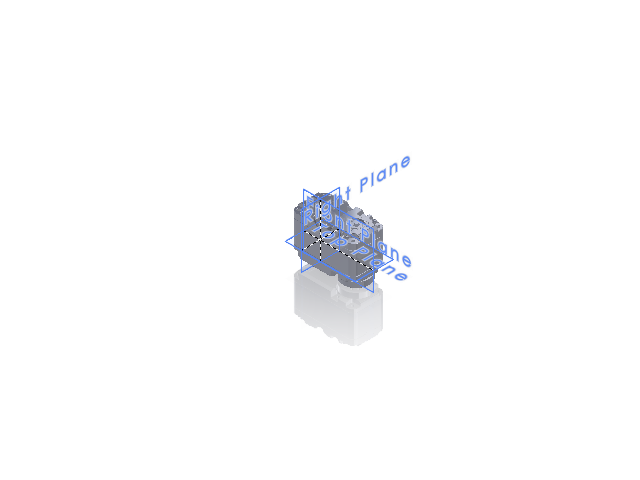
[picture p128: CAD file, 2024-12-19]
robocup cad/jed96/[HerkuleX] DRS-010X.SLDASM
CASE_228.stp
TOP_191.stp
MR106_9.stp
BOTTOM_CASE_290.stp
HORN_44.stp
KSB1023A_T2X25NI_147.stp x 4
INNER_NUT_14.stp x 6
KSB1023A_M2_5X8Z_147.stp
LED_LENSE_101.stp
