TheDarkKiwi/RoboCup/(list of files, cad)

Other CAD files:
robocup cad/jed96/[HerkuleX] DRS-010X.stp.SLDASM
robocup cad/jed96/TORQUE_VERSION_12_017_ASM_223_A_ASM.stp.SLDASM
robocup cad/jed96/TORQUE_VERSION_12_017_ASM_ASM_ASM.stp.SLDASM
robocup cad/DLparts/vl53l0xslightlyworser/vl53l0x_PCB.SLDPRT
robocup cad/jed96/MR106_9.stp.SLDPRT
robocup cad/WheelSlider.SLDPRT
robocup cad/DLparts/herculex-1.snapshot.1/Joint/DRJ-0002.step
robocup cad/Large_wheel.SLDPRT
robocup cad/joint/Custom Side Plate.SLDPRT
robocup cad/dee21/Custom Side Plate.SLDPRT
robocup cad/jed96/electromagnet.SLDPRT
robocup cad/jed96/60kg servo mount.SLDPRT
robocup cad/dee21/3d pulley.STL
robocup cad/jed96/CASE_228.stp.SLDPRT
robocup cad/jed96/belt sled.SLDPRT
robocup cad/jed96/KSB1023A_M2_5X8Z_147.stp.SLDPRT
robocup cad/jed96/TOP_191.stp.SLDPRT
robocup cad/joint/Belt1-1.SLDPRT
robocup cad/jed96/180x180 plate fixed.SLDPRT
robocup cad/joint/Target Weight_PIMPED.SLDPRT
robocup cad/jed96/Part1.SLDPRT
robocup cad/jed96/Target Weight.SLDPRT
robocup cad/jed96/smartservobracket true.SLDPRT
robocup cad/dee21/184x274 plate.SLDPRT
robocup cad/jed96/LED_LENSE_101.stp.SLDPRT
robocup cad/jed96/KSB1023A_T2X25NI_147.stp.SLDPRT
robocup cad/jed96/BOTTOM_CASE_290.stp.SLDPRT
robocup cad/jed96/HORN_44.stp.SLDPRT
robocup cad/DLparts/herculex-1.snapshot.1/Joint/DRJ-0001.SLDPRT
robocup cad/DLparts/herculex-1.snapshot.1/Joint/DRJ-0001.igs
robocup cad/DLparts/herculex-1.snapshot.1/Joint/DRJ-0002.SLDPRT
robocup cad/DLparts/herculex-1.snapshot.1/Joint/DRJ-0002.igs
robocup cad/DLparts/herculex-1.snapshot.1/Joint/DRJ-0003.SLDPRT
robocup cad/DLparts/herculex-1.snapshot.1/Joint/DRJ-0003.igs
robocup cad/DLparts/herculex-1.snapshot.1/Joint/DRJ-0004.SLDPRT
robocup cad/DLparts/herculex-1.snapshot.1/Joint/DRJ-0004.igs
robocup cad/DLparts/herculex-1.snapshot.1/Joint/DRJ-0006.SLDPRT
robocup cad/DLparts/herculex-1.snapshot.1/Joint/DRJ-0006.igs
robocup cad/DLparts/herculex-1.snapshot.1/Joint/DRJ-0007.SLDPRT
robocup cad/DLparts/herculex-1.snapshot.1/Joint/DRJ-0007.igs
robocup cad/DLparts/herculex-1.snapshot.1/Joint/DRJ-0008.SLDPRT
robocup cad/DLparts/herculex-1.snapshot.1/Joint/DRJ-0008.igs
robocup cad/DLparts/herculex-1.snapshot.1/Joint/DRJ-0009.SLDPRT
robocup cad/DLparts/herculex-1.snapshot.1/Joint/DRJ-0009.igs
robocup cad/DLparts/herculex-1.snapshot.1/Joint/DRJ-0010.SLDPRT
robocup cad/DLparts/herculex-1.snapshot.1/Joint/DRJ-0010.igs
robocup cad/DLparts/herculex-1.snapshot.1/Joint/[DRJ-0011] Bushing Set_female.SLDPRT
robocup cad/DLparts/herculex-1.snapshot.1/Joint/[DRJ-0011] Bushing Set_female.igs
robocup cad/DLparts/herculex-1.snapshot.1/Joint/[DRJ-0011] Bushing Set_male.SLDPRT
robocup cad/DLparts/herculex-1.snapshot.1/Joint/[DRJ-0011] Bushing Set_male.igs
robocup cad/DLparts/herculex-1.snapshot.1/bracket/DRB-0001.SLDPRT
robocup cad/DLparts/herculex-1.snapshot.1/bracket/DRB-0002.SLDPRT
robocup cad/DLparts/herculex-1.snapshot.1/bracket/DRB-0003.SLDPRT
robocup cad/DLparts/herculex-1.snapshot.1/bracket/DRB-0003.igs
robocup cad/DLparts/herculex-1.snapshot.1/bracket/DRB-0004.SLDPRT
robocup cad/DLparts/herculex-1.snapshot.1/bracket/DRB-0004.igs
robocup cad/DLparts/herculex-1.snapshot.1/bracket/DRB-0005.SLDPRT
robocup cad/DLparts/herculex-1.snapshot.1/bracket/DRB-0005.igs
robocup cad/DLparts/herculex-1.snapshot.1/bracket/DRB-0007.SLDPRT
robocup cad/DLparts/herculex-1.snapshot.1/bracket/DRB-0009.SLDPRT
robocup cad/DLparts/herculex-1.snapshot.1/bracket/DRB-0009.igs
robocup cad/DLparts/herculex-1.snapshot.1/bracket/DRB-0010.SLDPRT
robocup cad/DLparts/herculex-1.snapshot.1/bracket/DRB-0010.igs
robocup cad/DLparts/herculex-1.snapshot.1/bracket/DRB-0011.SLDPRT
robocup cad/DLparts/herculex-1.snapshot.1/motor/DSR-040X.SLDPRT
robocup cad/DLparts/herculex-1.snapshot.1/motor/DSR-040X.igs
robocup cad/DLparts/herculex-1.snapshot.1/motor/DSR-060X.SLDPRT
robocup cad/DLparts/herculex-1.snapshot.1/motor/DSR-060X.igs
robocup cad/DLparts/vl5310xother/Sensor Mount - 2.STL
robocup cad/DLparts/vl5310xother/Sensor Mount.STL
robocup cad/DLparts/vl5310xother/VL53l1X.IGS
robocup cad/DLparts/vl5310xother/VL53l1X.SLDPRT
robocup cad/DLparts/vl53l0xslightlyworser/vl53l0x.SLDASM
robocup cad/SKIDS.STL
robocup cad/WheelSliderEDIT.STL
robocup cad/WheelSliderEDIT2.STL
robocup cad/dee21/180x180 plate.DXF
robocup cad/dee21/184x274 plate.DXF
robocup cad/dee21/BeltOther.SLDDRW
robocup cad/dee21/Custom Side Plate.DXF
robocup cad/dee21/Custom Side Plate.SLDDRW
robocup cad/dee21/Custom Side Plate2.DXF
robocup cad/dee21/Custom Side Plate2.SLDPRT
robocup cad/dee21/Door2.STL
robocup cad/dee21/Internal passage way.SLDDRW
robocup cad/dee21/Internal passage way.STL
robocup cad/dee21/servowallmount.STL
robocup cad/dee21/side2collection.STL
robocup cad/dee21/side2collection2.STL
robocup cad/dee21/side2collection3.STL
robocup cad/dee21/side2top.STL
robocup cad/jed96/Battery holder.STL
robocup cad/jed96/INNER_NUT_14.stp.SLDPRT
robocup cad/jed96/Internal passage way front ramp 2.STL
robocup cad/jed96/Internal passage way front ramp.STL
robocup cad/jed96/Internal passage way.STL
robocup cad/jed96/Large_wheel_true.STL
robocup cad/jed96/Smart servo gate.STL
robocup cad/jed96/belt sled.STL
robocup cad/jed96/belt sled8mm.STL
robocup cad/jed96/servowallmount2.STL
robocup cad/joint/Custom Side Plate.DXF
robocup cad/joint/Custom Side Plate2.SLDPRT
