TheDarkKiwi/RoboCup/robocup cad/eak38/TEST.jpg

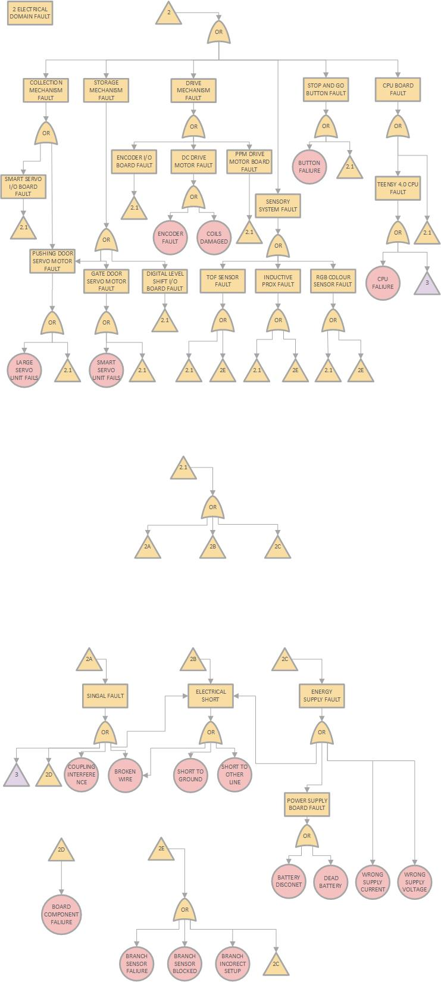
robocup cad/eak38/TEST.jpg
