TheDarkKiwi/RoboCup/robocup cad/eak38/TEST.pdf

1.0 ROBOT FALIURE
TO COLLECT AND
CONTAIN TARGET
WEIGHT

STOP AND GO
BUTTON FAULT

SHORT SINGAL FAULT

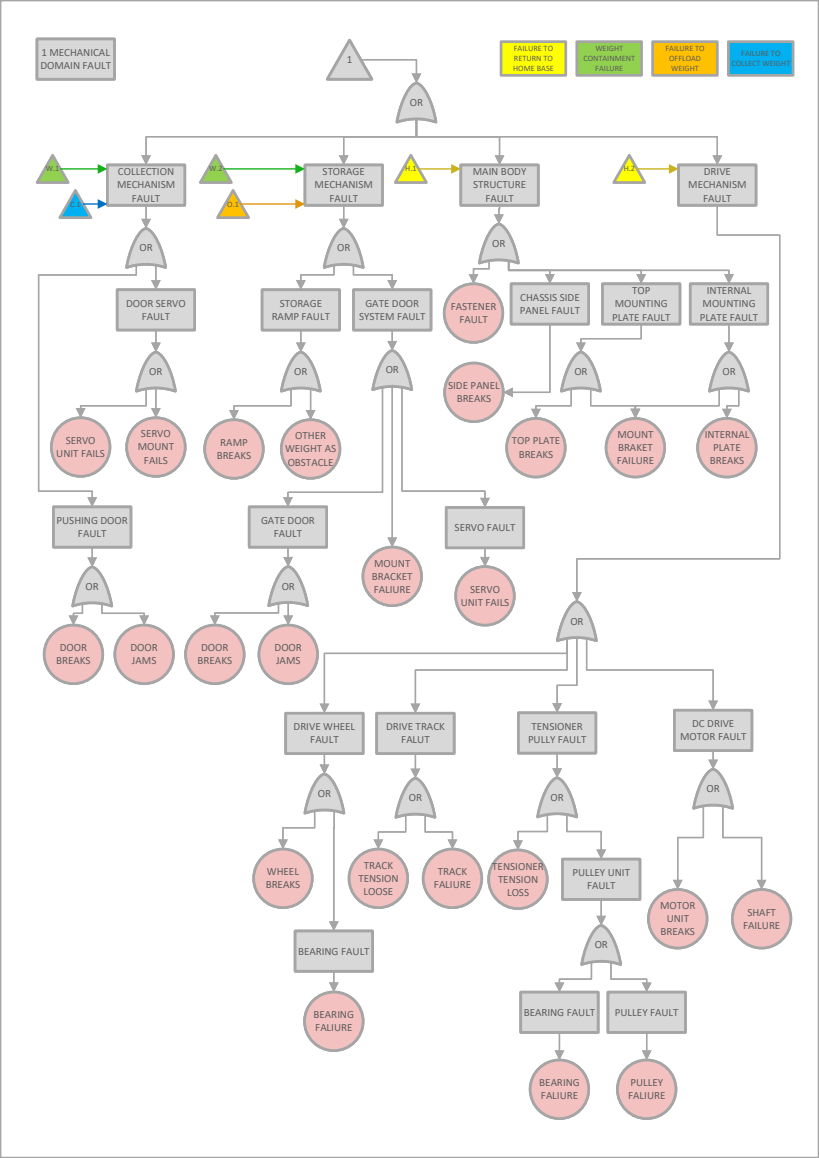
[picture p130: page 2]
COLLECTION MECHANISM FAULT; DC DRIVE MOTOR FAULT; DOOR SERVO FAULT; STORAGE MECHANISM FAULT; DRIVE MECHANISM FAULT; MAIN BODY STRUCTURE FAULT; PUSHING DOOR FAULT; STORAGE RAMP FAULT; GATE DOOR SYSTEM FAULT; GATE DOOR; FAULT; SERVO FAULT; DRIVE WHEEL FAULT; DRIVE TRACK FALUT; TENSIONER PULLY FAULT; PULLEY UNIT FAULT; BEARING FAULT; DOOR BREAKS; DOOR JAMS; SERVO UNIT FAILS; RAMP BREAKS; TRACK TENSION LOOSE; TRACK FALIURE; MOTOR UNIT BREAKS; TENSIONER TENSION LOSS; BEARING FALIURE; WHEEL BREAKS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
