TheDarkKiwi/RoboCup/robocup cad/dee21/Custom Side Plate.pdf

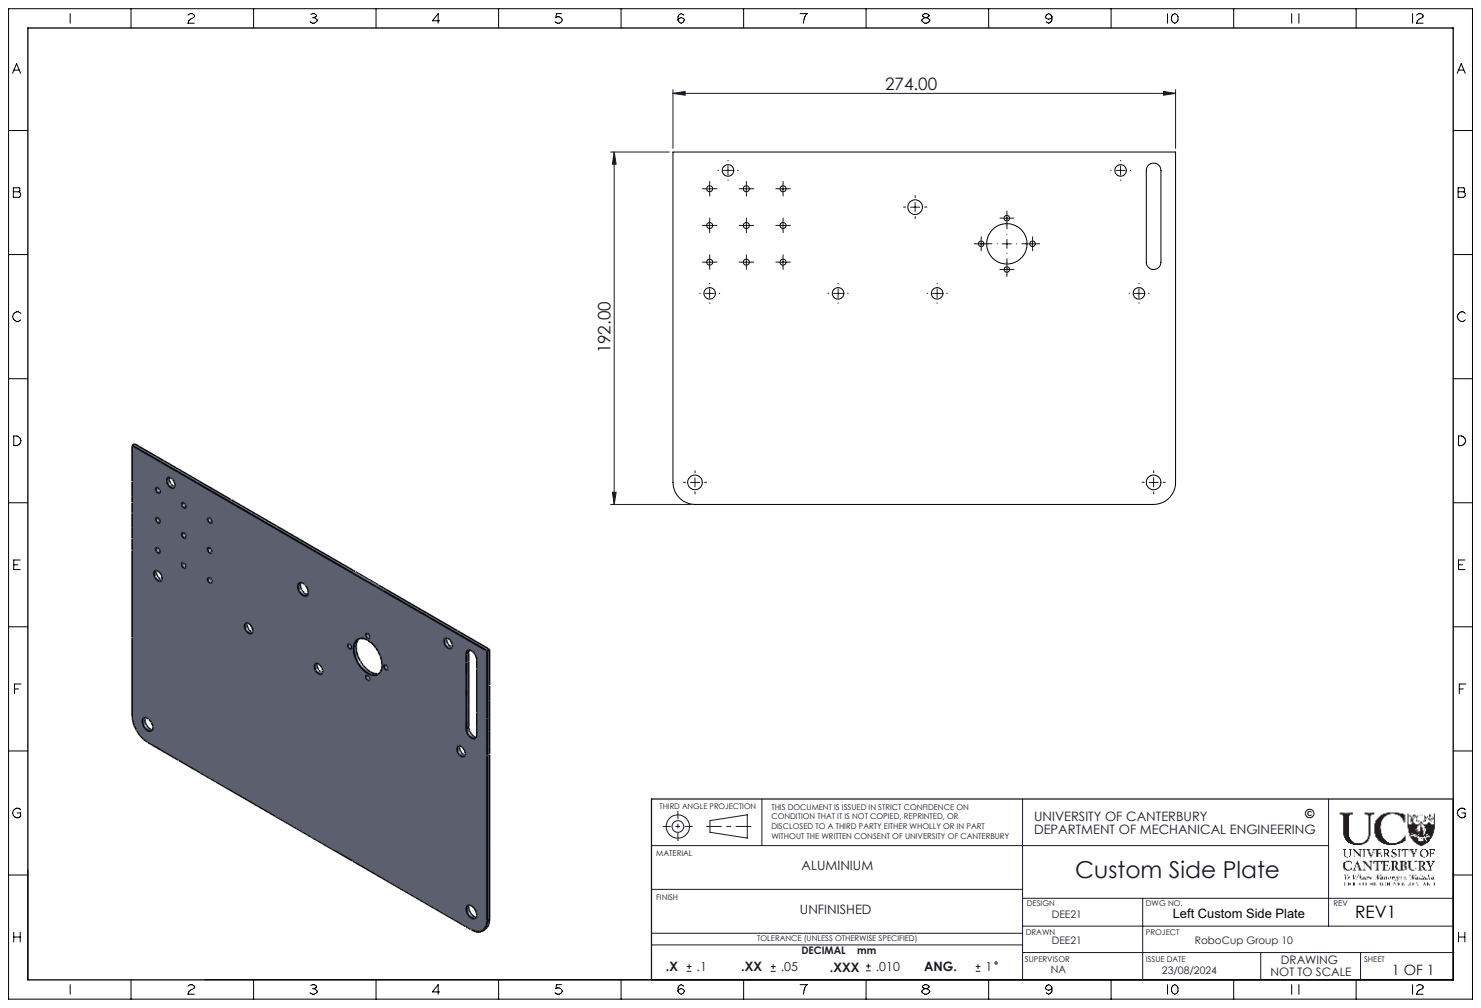
[picture p131: page 1]
.XXX .010

THIRD ANGLE PROJECTION | THIS DOCUMENT IS ISSUED IN STRICT CONFIDENCE ON CONDITION THAT IT IS NOT COPIED, REPRINTED, OR DISCLOSED TO A THIRD PARTY EITHER WHOLLY OR IN PART WITHOUT THE WRITTEN CONSENT OF UNIVERSITY OF CANTERBURY | © UNIVERSITY OF CANTERBURY DEPARTMENT OF MECHANICAL ENGINEERING
MATERIAL ALUMINIUM | | Custom Side Plate

DESIGN DEE21 | DWG NO. Left Custom Side Plate | REV REV1

TOLERANCE (UNLESS OTHERWISE SPECIFIED)
DECIMAL mm

DRAWN DEE21 | PROJECT RoboCup Group 10
SUPERVISOR NA | ISSUE DATE 23/08/2024 | DRAWING NOT TO SCALE | SHEET 1 OF 1
