TheDarkKiwi/RoboCup/robocup cad/dee21/Internal passage way.pdf

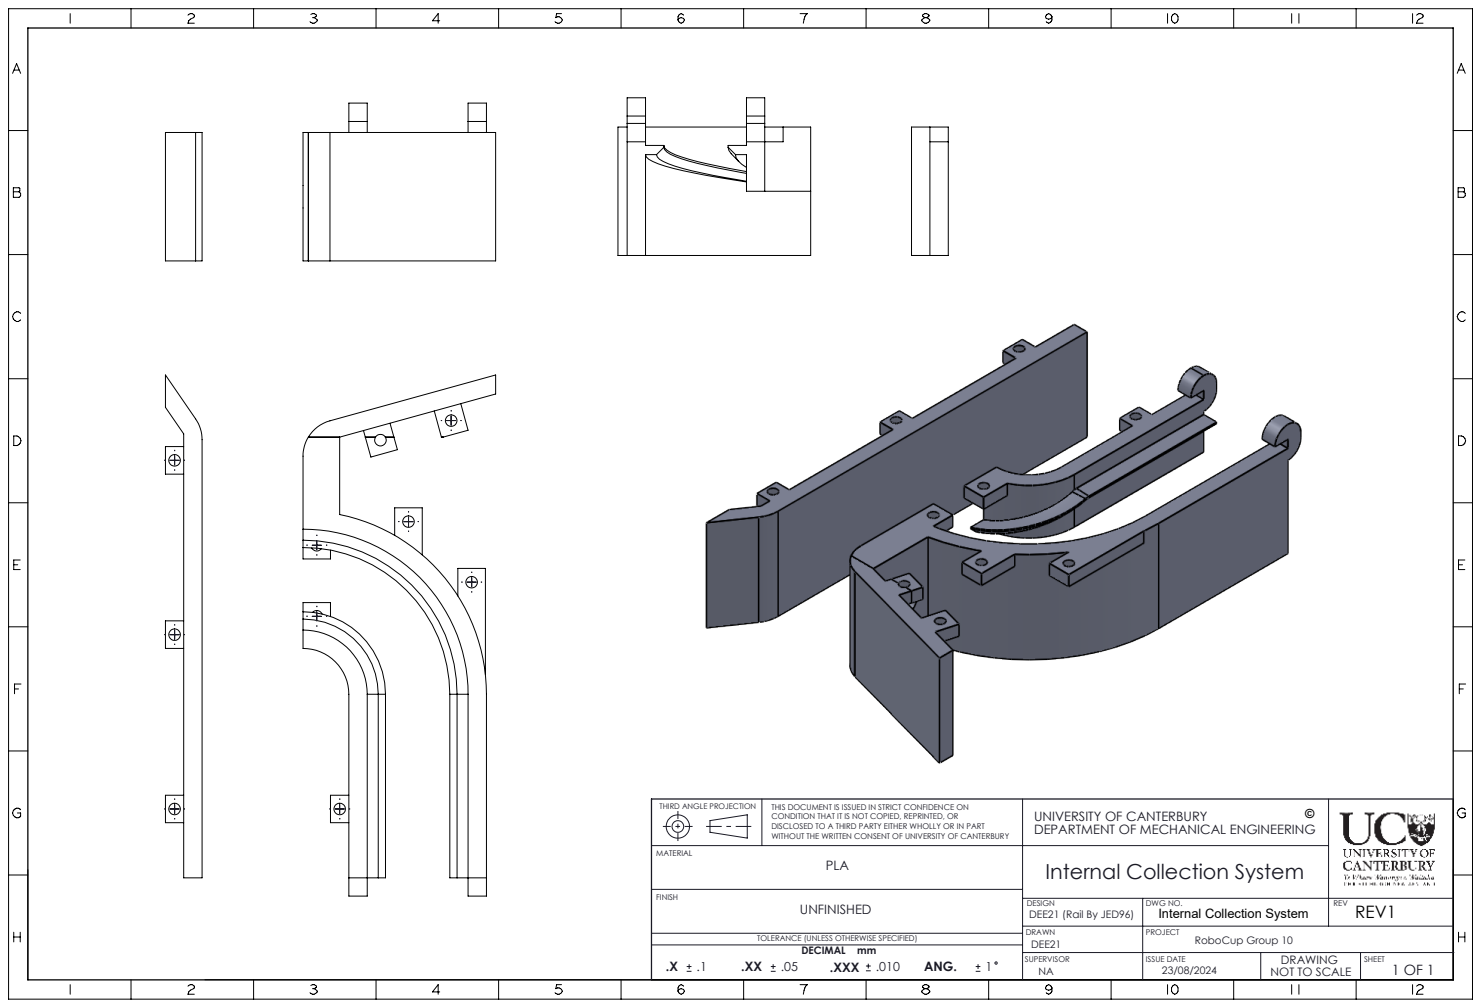
[picture p132: page 1]
.XXX .010

THIRD ANGLE PROJECTION | THIS DOCUMENT IS ISSUED IN STRICT CONFIDENCE ON CONDITION THAT IT IS NOT COPIED, REPRINTED, OR DISCLOSED TO A THIRD PARTY EITHER WHOLLY OR IN PART WITHOUT THE WRITTEN CONSENT OF UNIVERSITY OF CANTERBURY | © UNIVERSITY OF CANTERBURY DEPARTMENT OF MECHANICAL ENGINEERING
MATERIAL PLA | | Internal Collection System

DESIGN DEE21 (Rail By JED96) | DWG NO. Internal Collection System | REV REV1

TOLERANCE (UNLESS OTHERWISE SPECIFIED)
DECIMAL mm

DRAWN | PROJECT RoboCup Group 10 DEE21
SUPERVISOR NA | ISSUE DATE 23/08/2024 | DRAWING NOT TO SCALE | SHEET 1 OF 1
