TheDarkKiwi/RoboCup/robocup cad/eak38/CODE/bk_deltetemeifneeded/robocup-main/include/motors.h

//************************************
//         motors.h    
//************************************

#ifndef MOTORS_H_
#define MOTORS_H_

#include <Servo.h>
#include <stdint.h>

// SET THIS TO REAL VALUES
#define ROBOT_SERVO_PIN 30    //Pin corresponding to the robot servo
#define LEFT_MOTOR_PIN 0      //Pin corresponding to the left dc motor
#define RIGHT_MOTOR_PIN 1     //Pin corresponding to the right dc motor
#define ROBOT_SERVO_MIN 544   //Minimum value for the robot servo
#define ROBOT_SERVO_MAX 1920  //Maximum value for the robot servo
#define DRIVE_MOTOR_MAX_REVERSE 1050    //Minimum value for the left dc motor
#define DRIVE_MOTOR_STOP 1500  //Minimum value for the left dc motor
#define DRIVE_MOTOR_MAX 1950   //Maximum value for the left dc motor

#define MOTOR_PID_FREQUENCY 200
#define MIN_UPDATE_TIME 0 //30000000

extern int targetLeftSpeed;
extern int targetRightSpeed;


enum PinAssignments {
  encoder1PinA = 2,
  encoder1PinB = 3,
  
  encoder2PinA = 4,
  encoder2PinB = 5,
};

enum MotorSide {
  LEFT,
  RIGHT
};

void motors_init(void);

void motors_encoder_init(void);

void motors_drive(MotorSide motor, int16_t speed);

void motors_PID_drive(void);

void doEncoder1A();

void doEncoder2A();

void applyEMA(int64_t &smoothedSpeed, int64_t rawSpeed);

void motors_print(void);

void motors_calculate_speed();

uint32_t getCycleCount();

void enableCycleCounter();





#endif /* MOTORS_H_ */
