TheDarkKiwi/RoboCup/robocup cad/eak38/CODE/robocup_template/motors.cpp

#include "motors.h"
#include "Arduino.h"

/* Check whether the speed value to be written is within the maximum
 *  and minimum speed caps. Act accordingly.
 *
 */
void check_speed_limits(/*parameters*/) {
  Serial.println("Check the motor speed limit \n");
}


/* In this section, the motor speeds should be updated/written.
 *It is also a good idea to check whether value to write is valid.
 *It is also a good idea to do so atomically!
 */
void set_motor(/*parameters*/) {

  Serial.println("Change the motor speed \n");
  
  check_speed_limits();

}
