TheDarkKiwi/RoboCup/robocup cad/eak38/CODE/bk_deltetemeifneeded/robocup-main/include/HC_SR04.h

#ifndef HC_SR04_H
#define HC_SR04_H

#include <Arduino.h>

#define CM true

class HC_SR04 {
  public:
    HC_SR04(int trigger, int echo, int interrupt, int max_dist=200);
    
    void begin();
    void start();
    bool isFinished(){ return _finished; }
    unsigned int getRange(bool units=CM);
    static HC_SR04* instance(){ return _instance; }
    
  private:
    static void _echo_isr();
    
    int _trigger, _echo, _int, _max;
    volatile unsigned long _start, _end;
    volatile bool _finished;
    static HC_SR04* _instance;
};

#endif
