TheDarkKiwi/RoboCup/robocup cad/eak38/CODE/bk_deltetemeifneeded/robocup-main/include/navigate.h

#ifndef NAVIGATE_H
#define NAVIGATE_H

#define WALL_FOLLOW_DISTANCE 200

#define START_WALL_FOLLOW_DISTANCE 400

void navigate_to_weight();

void navigate_wall_follow(bool left);

void navigate_logic();

void navigate_drop_weight();

#endif // NAVIGATE_H
