TheDarkKiwi/RoboCup/robocup cad/eak38/CODE/robocup_template/return_to_base.cpp

//************************************
//         return_to_base.cpp       
//************************************

 // This file contains functions used to return to and
 // detect bases

#include "return_to_base.h"
#include "Arduino.h"

// Local definitions
//#define 

// Return to home base
void return_to_base(/* Parameters */){
  Serial.println("Returning to base \n");
}

// Detect what base (if any) the robot is above
void detect_base(/* Parameters */){
  Serial.println("Base detected \n");
}

// Unload weights in home base
void unload_weights(/* Parameters */){
  Serial.println("Unloading weights \n");
}
